xinshuanglong/PLC2STM-Project/流程图/工控机固定站调试图.png

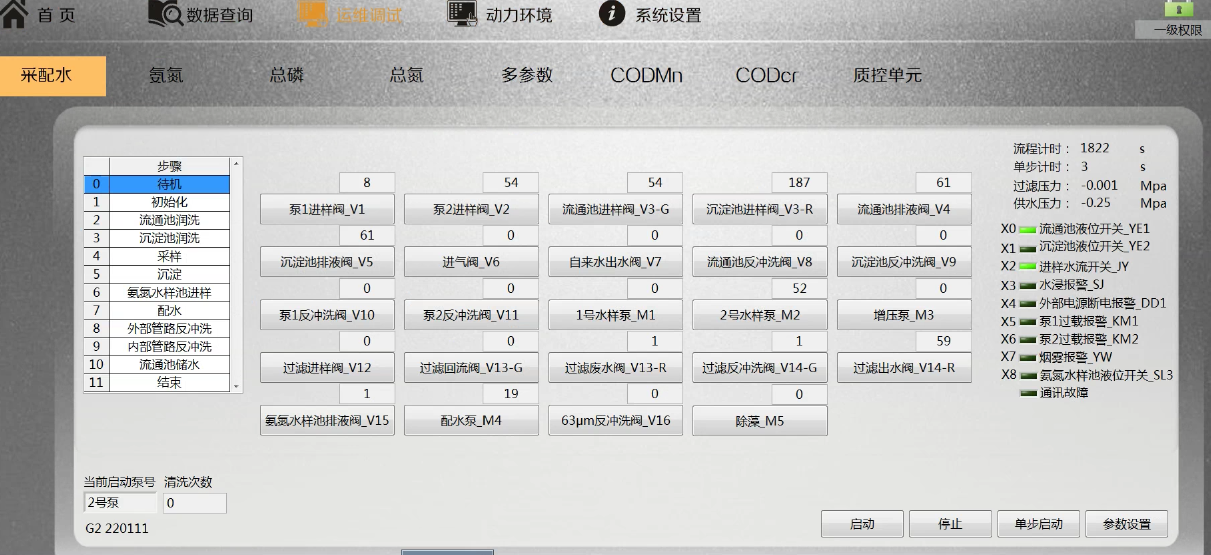
流程图/工控机固定站调试图.png
