xinshuanglong/PLC2STM-Project/流程图/一体站采配水运行逻辑图.pdf

待机 | 程序初始化 | 水箱润洗

一级水样池进
样

二级水样池进
样

多参数测量及
水样沉淀

配水

一级水样池储
水

结束

是（多参数测量完成后直接进入反冲洗流程）

水流开关及液
位开关在设定
时间内是否有
信号输出？

是否只测
多参数？

是

水流开关及液
位开关在设定
时间内是否有
信号输出?

否（发出进样超时报警，流程进入一级水样池储水流程，储水完成后进入待机状态）

是

是否启用
氨氮过滤
装置?

否（发出进样超时报警，流程进入一级水样池储水流程，储水完成后进入待机状态）

氨氮水样过滤

是

反冲洗

1. 一级水样池润洗：开启采水泵1切换阀V1-G、一级排液阀 V5，5s后开启1号水样泵M1，进行一级水样池润洗。润洗时间 到后，关闭V5，当一级液位开关信号输出后，关闭M1和V1-G。一级水样池润洗时间默认设置30s，可设置。

2.二级水样池润洗：
开启二级排液阀V4、二级进样阀V6-R，5s后开启配水泵M3， 润洗时间到后，关闭M3、二级进样阀V6-R，同时开启V5，默 认排液时间到后，关闭V4、V5。在二级水样池润洗期间，当一 级液位开关不输出信号时，一级水样池进行补水。补水流程：开 启V1-G、5s后开启M1，当一级液位开关信号输出后，关闭 M1、V1-G，补水完成。二级水样池池润洗时间默认设置30s， 可设置。

开启一级排液阀V5、二
级排液阀V4，排液时间
默认设置30s，可设置

开启采水泵1切换阀V1-G、
5s后开启1号水样泵M1，
当一级液位开关信号输出
后，关闭M1和V1-G。

开启二级进样阀V6-R，5s后开启配
水泵M3，当二级液位开关信号输出
后，关闭M3、V6-R。在二级水样池
进样期间，当一级液位开关不输出信
号时，一级水样池进行补水。补水流
程：开启V1-G、5s后开启1号水样泵
M1，当一级液位开关信号输出后，
关闭M1、V1-G，补水完成。

沉淀时间默认1800s, 可设置。

否

1.常规配水时间默认1800s，加标回收配
水时间默认5400s，可设置。
2.配水期间，若氨氮水样池液位低于液位
开关，自动启动过滤补水。补水流程为：
开启过滤装置进样阀V6-G、过滤装置回流
阀V11-G、过滤出水阀V12-R，5s后开启
配水泵M3，氨氮水样池液位开关输出信号
后，关闭M3、V6-G、V11-G、V12-R，
完成氨氮水样池补水。

1.过滤装置润洗：
启动过滤水样池排液阀V13，排液时间到后，开启过
滤装置进样阀V6-G，过滤装置废水阀V11-R，过滤出 水阀V12-R,5s后启动配水泵M3，进行过滤装置润 洗，润洗时间默认设置10s,时间可设置。
2.氨氮水样池润洗：
过滤装置润洗时间到后，关闭M3,V11-R,开启过滤装 置回流阀V11-G,5s后启动配水泵M3,进行氨氮水样池 润洗。润洗时间默认10s，时间可设置。
3.过滤进样：
氨氮水样池润洗时间到后，关闭过滤水样池排液阀
V13,进行过滤进样，氨氮水样池液位开关输出信号
后，关闭M3、过滤装置进样阀V6-G、过滤装置回流
阀V11-G，完成过滤进样流程。
4.异常报警：
若过滤进样时间超过设定值，直接进入配水流程，同
时输出报警过滤装置异常，氨氮模块停止测量。
5.保护程序：
在过滤装置和氨氮水样池润洗时，若氨氮水样池液位
开关输出信号，则关闭除了过滤水样池排液阀V13的
所有阀和泵，默认排液时间到后，关闭V13，进入待
机状态

1.若选择水样储水：
开启采水泵1切换阀V1-G,5s后开启1号水样泵M1，到 达设定的储水时间或者一级液位开关输出信号后，关
闭M1和V1-G,完成储水。储水时间可设置。
2.若选择进自来水储水：
开启过滤装置出水阀V12-R，一级反冲洗阀V2、自来 水出水阀V8,5s后开启增压泵M4,到达设定的储水时间 或者一级水样池液位开关输出信号后，关闭M4、
V8、V12-R和V2，完成储水。储水时间可设置。

1.水箱排液：
开启一级排液阀V5，二级排液阀V4，排液时间到后，开启过滤水样池排液阀 V13。排液时间到后，关闭V4、V5和V13。排液时间默认30s,可设置。 2.外部管路反冲洗: 开启采水泵1切换阀V1-G、采水泵1反冲洗阀V9、过滤出水阀V12-R、自来水出水

阀V8,5s后开启增压泵M4，进行外部管路反冲洗，反冲洗时间到后，关闭M4、 V1-G、V8、V9和V12-R。外部管路反冲洗时间默认120s，可设置。 3.内部管路反冲洗：
3.1 开启63um滤芯反冲洗阀V14、二级进样阀V6-R、过滤装置进样阀V6-G、 过滤装置废水阀V11-R、自来水出水阀V8，5s后开启增压泵M4，进行63um滤芯 反冲洗，反冲洗时间到后，关闭M4、V8，开启空压机出气阀V7，进气时间到后， 关闭V7、V6-R、V6-G、V11-R、V14,完成63um滤芯反冲洗。进气时间默认 30s，可设置。
3.2 开启二级进样阀V6-R、过滤装置废水阀V11-R、过滤反冲洗阀V12-G、自 来水出水阀V8,5s后开启增压泵M4，过滤清洗时间到后，关闭M4、V8，开启空压 机出气阀V7,进气时间到后，关闭V7、V6-R、V11-R、V12-G,开启过滤出水阀 V12-R，完成过滤装置反冲洗。过滤装置反冲洗时间默认180s，可设置。 3.3开启一级排液阀V5，一级反冲洗阀V2，自来水出阀V8，5s后开启增压泵 M4，一级反冲洗时间到后，关闭M4、V8、V5、V2、完成一级水样池反冲洗。 一 级水样池反冲洗时间60s，可设置 。
3.4开启二级排液阀V4、二级反冲洗阀V3、自来水出水阀V8，5s后开启增压泵 M4，二级水样池反冲时间到后，关闭M4，V8，V4，V3，完成二级水样池反冲 洗。 二级水样池反冲洗时间60s，可设置。
3.5开启二级进样阀V6-R、过滤反冲洗阀V12-G，过滤装置废水阀V11-R,5s后 开启空压机出气阀V7，进气时间到后，关闭V7、V6-R、V11-R、V12-G,完成过滤 装置滤芯吹气。

否

# 微站采配水运行逻辑图

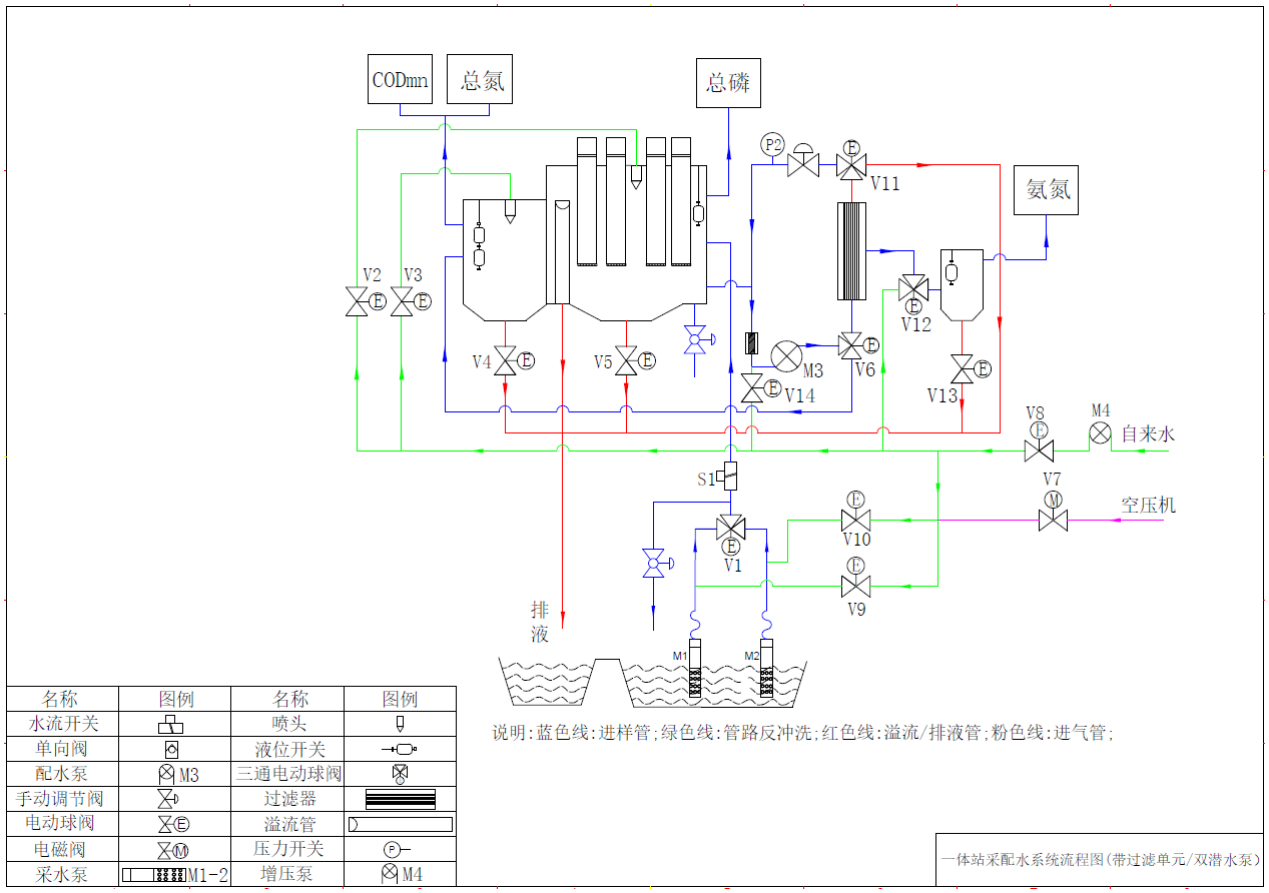
[picture p9: figure]
