xinshuanglong/PLC2STM-Project/流程图/工控机一体站配置图.png

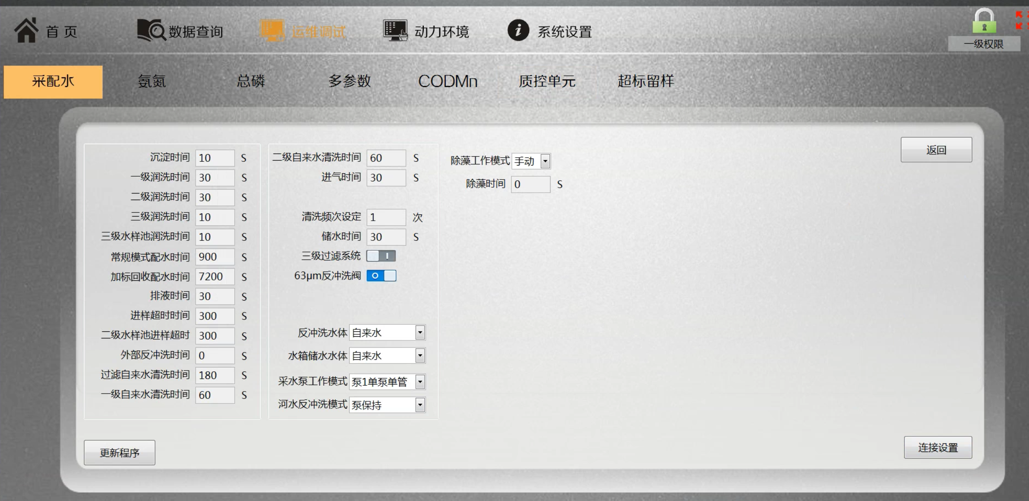
流程图/工控机一体站配置图.png
