xinshuanglong/PLC2STM-Project/Hardware/PLC转单片机主板总原理图设计-22.7.16.pdf

# JTAG TF卡

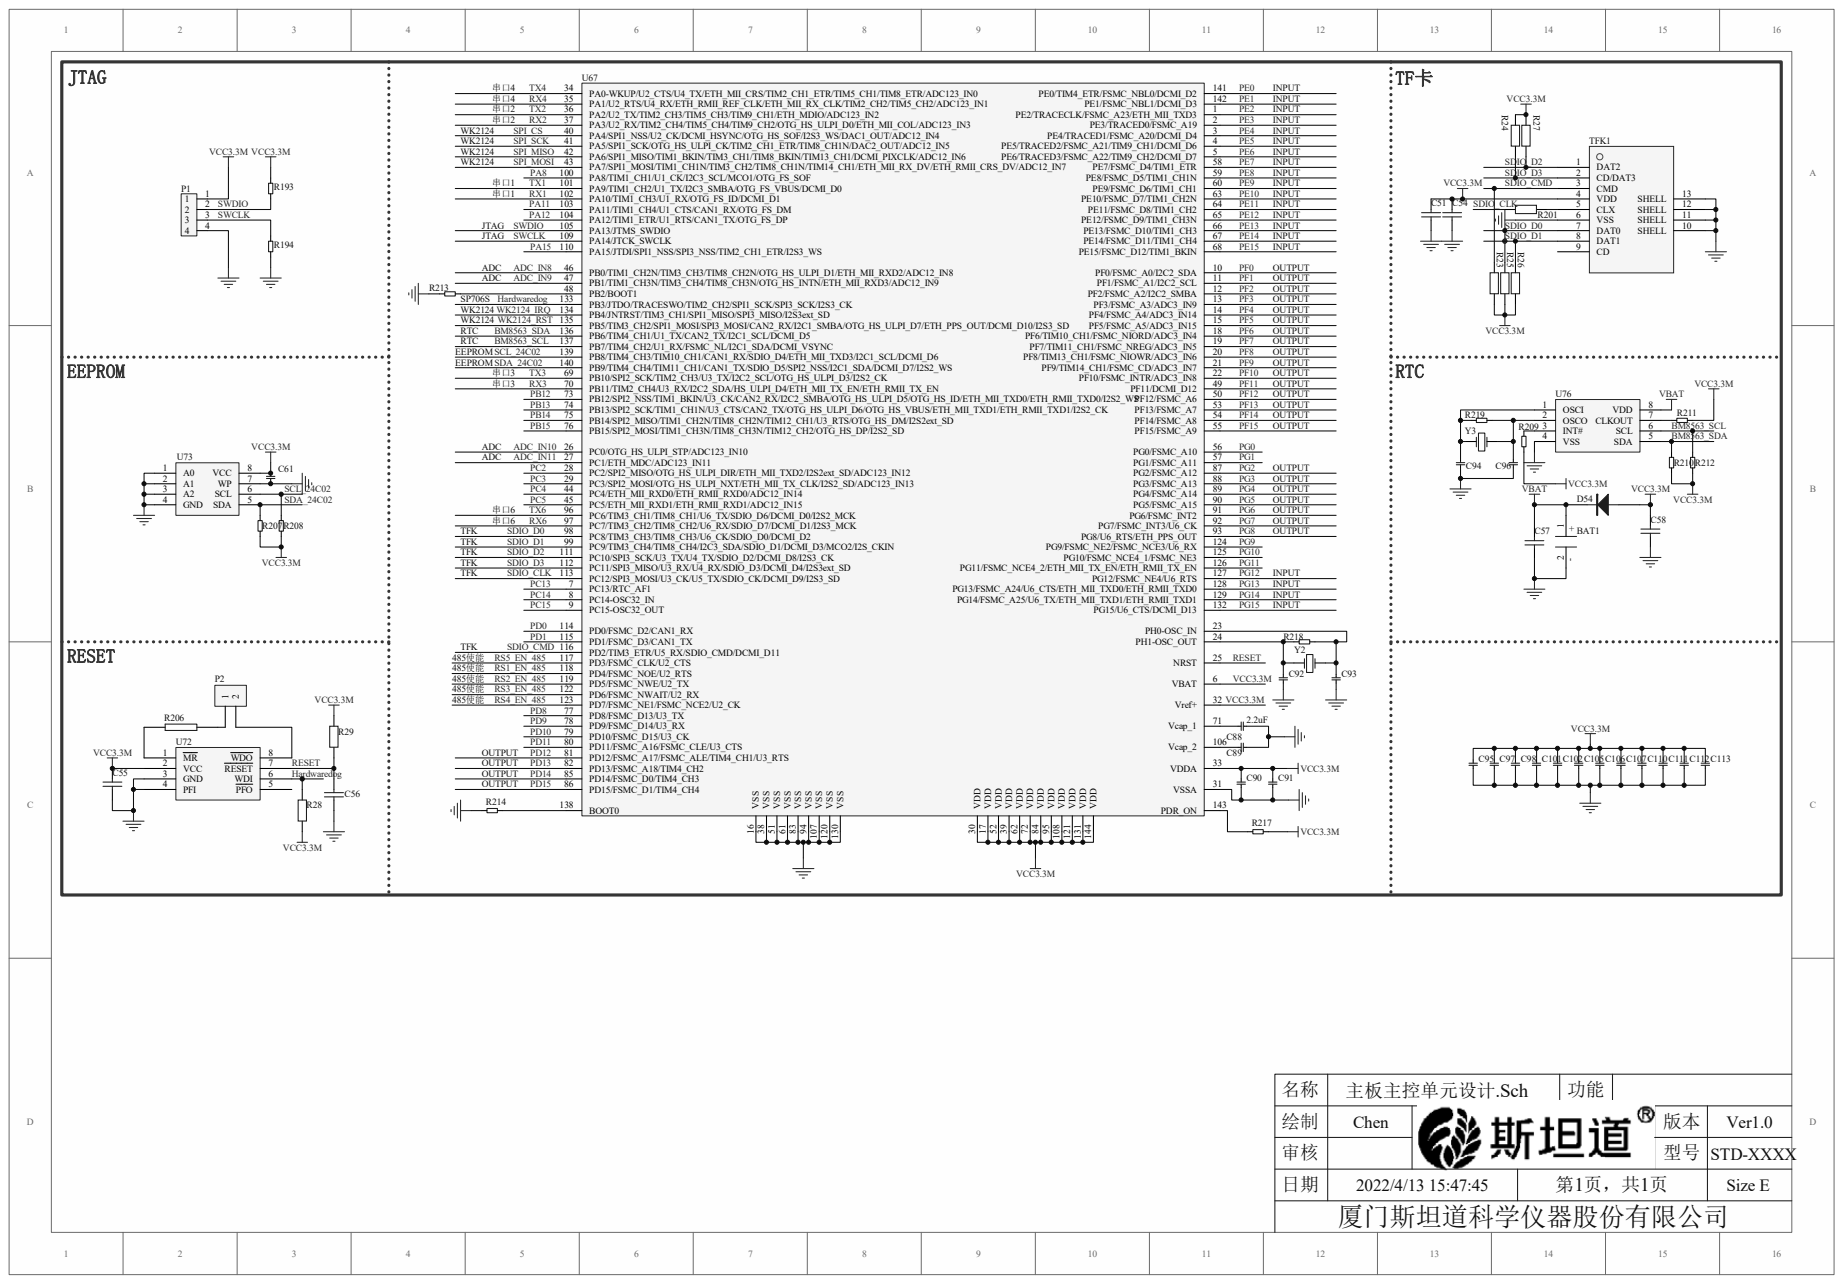
[picture p12: page 1]

# POWER INPUT Relay POWER SUPPLY

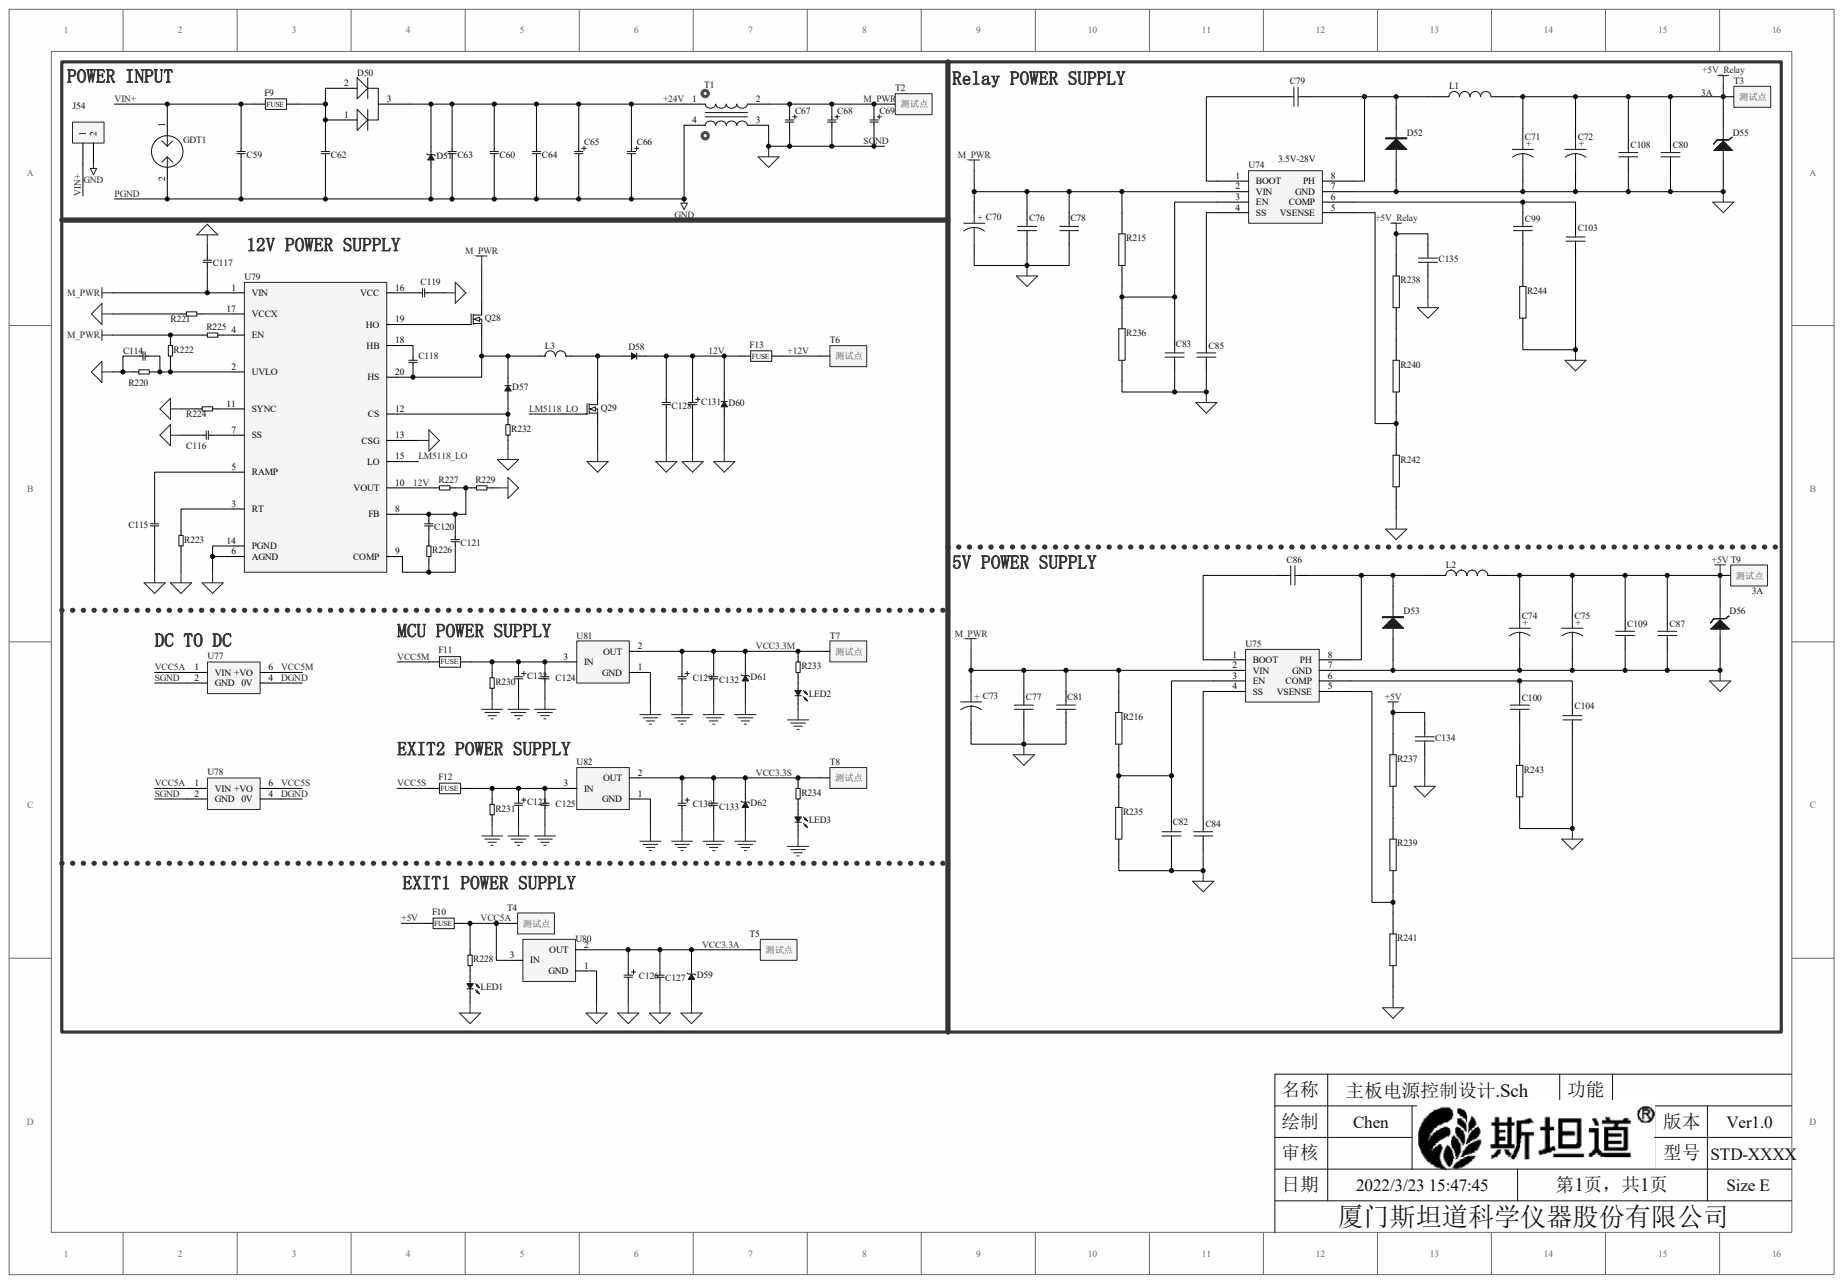
[picture p13: page 2]

MCU POWER SUPPLY DC TO DC

## RS232供电选择，两个电阻只能焊一个

232通讯

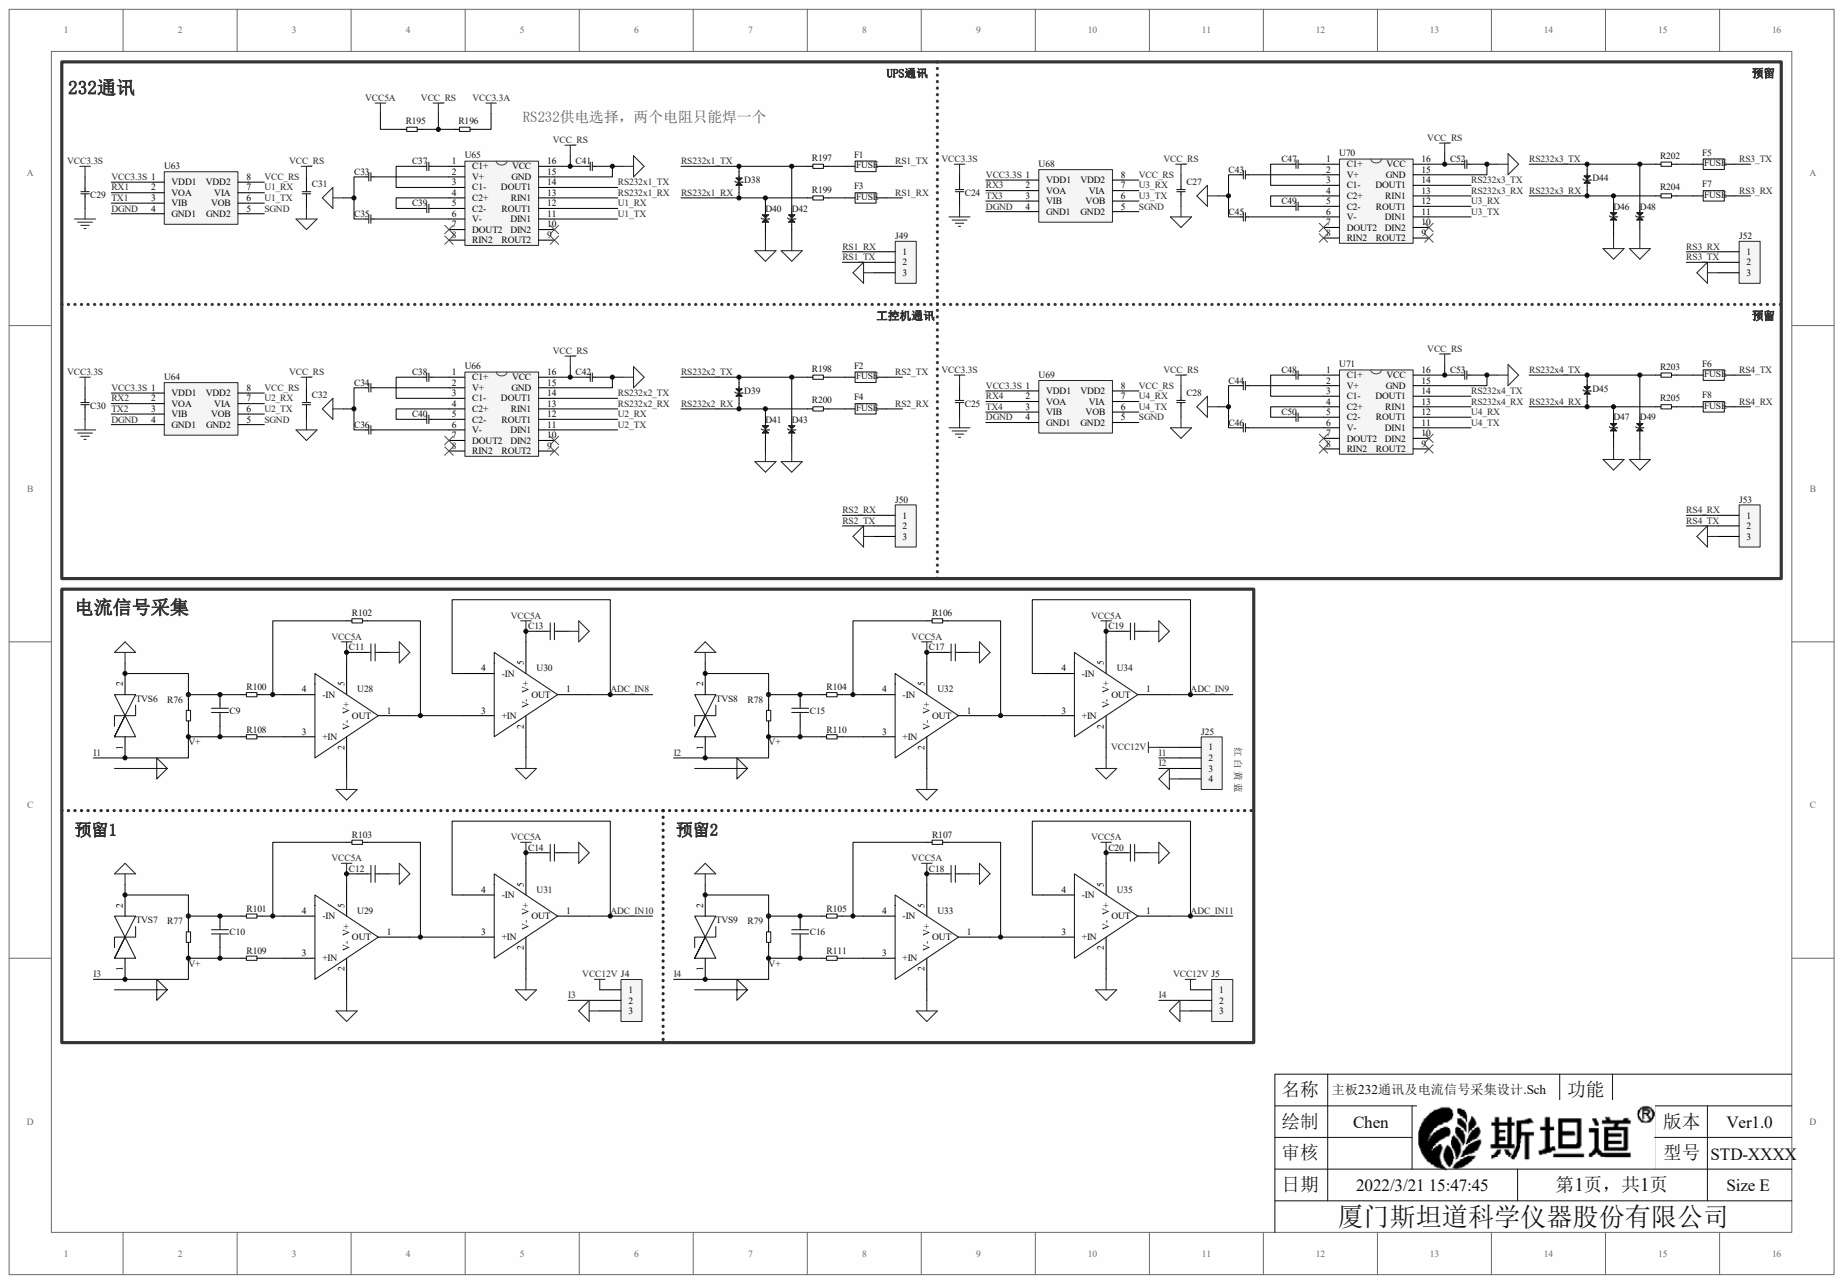
[picture p14: page 3]

485通讯

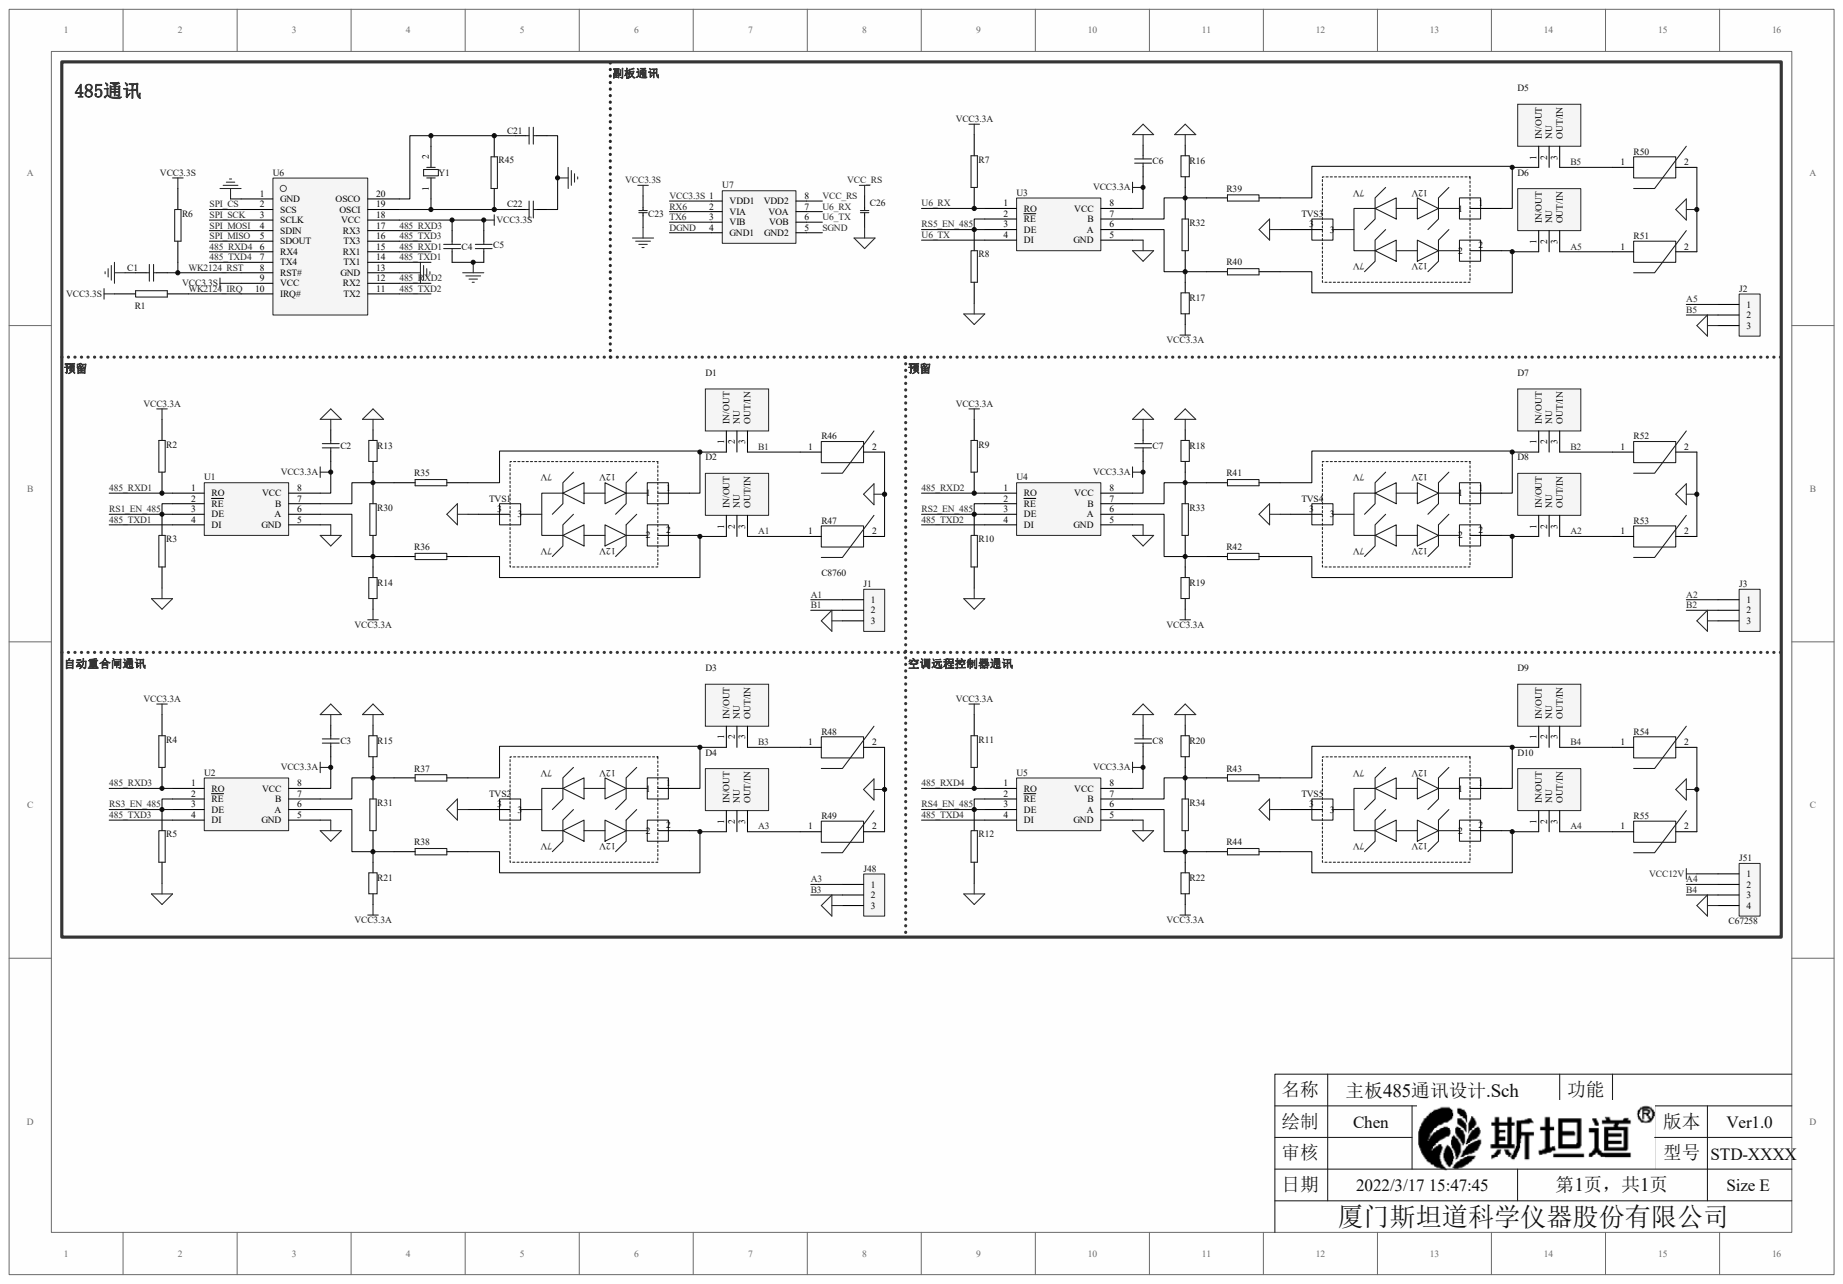
[picture p15: page 4]

## 12V Relay Control

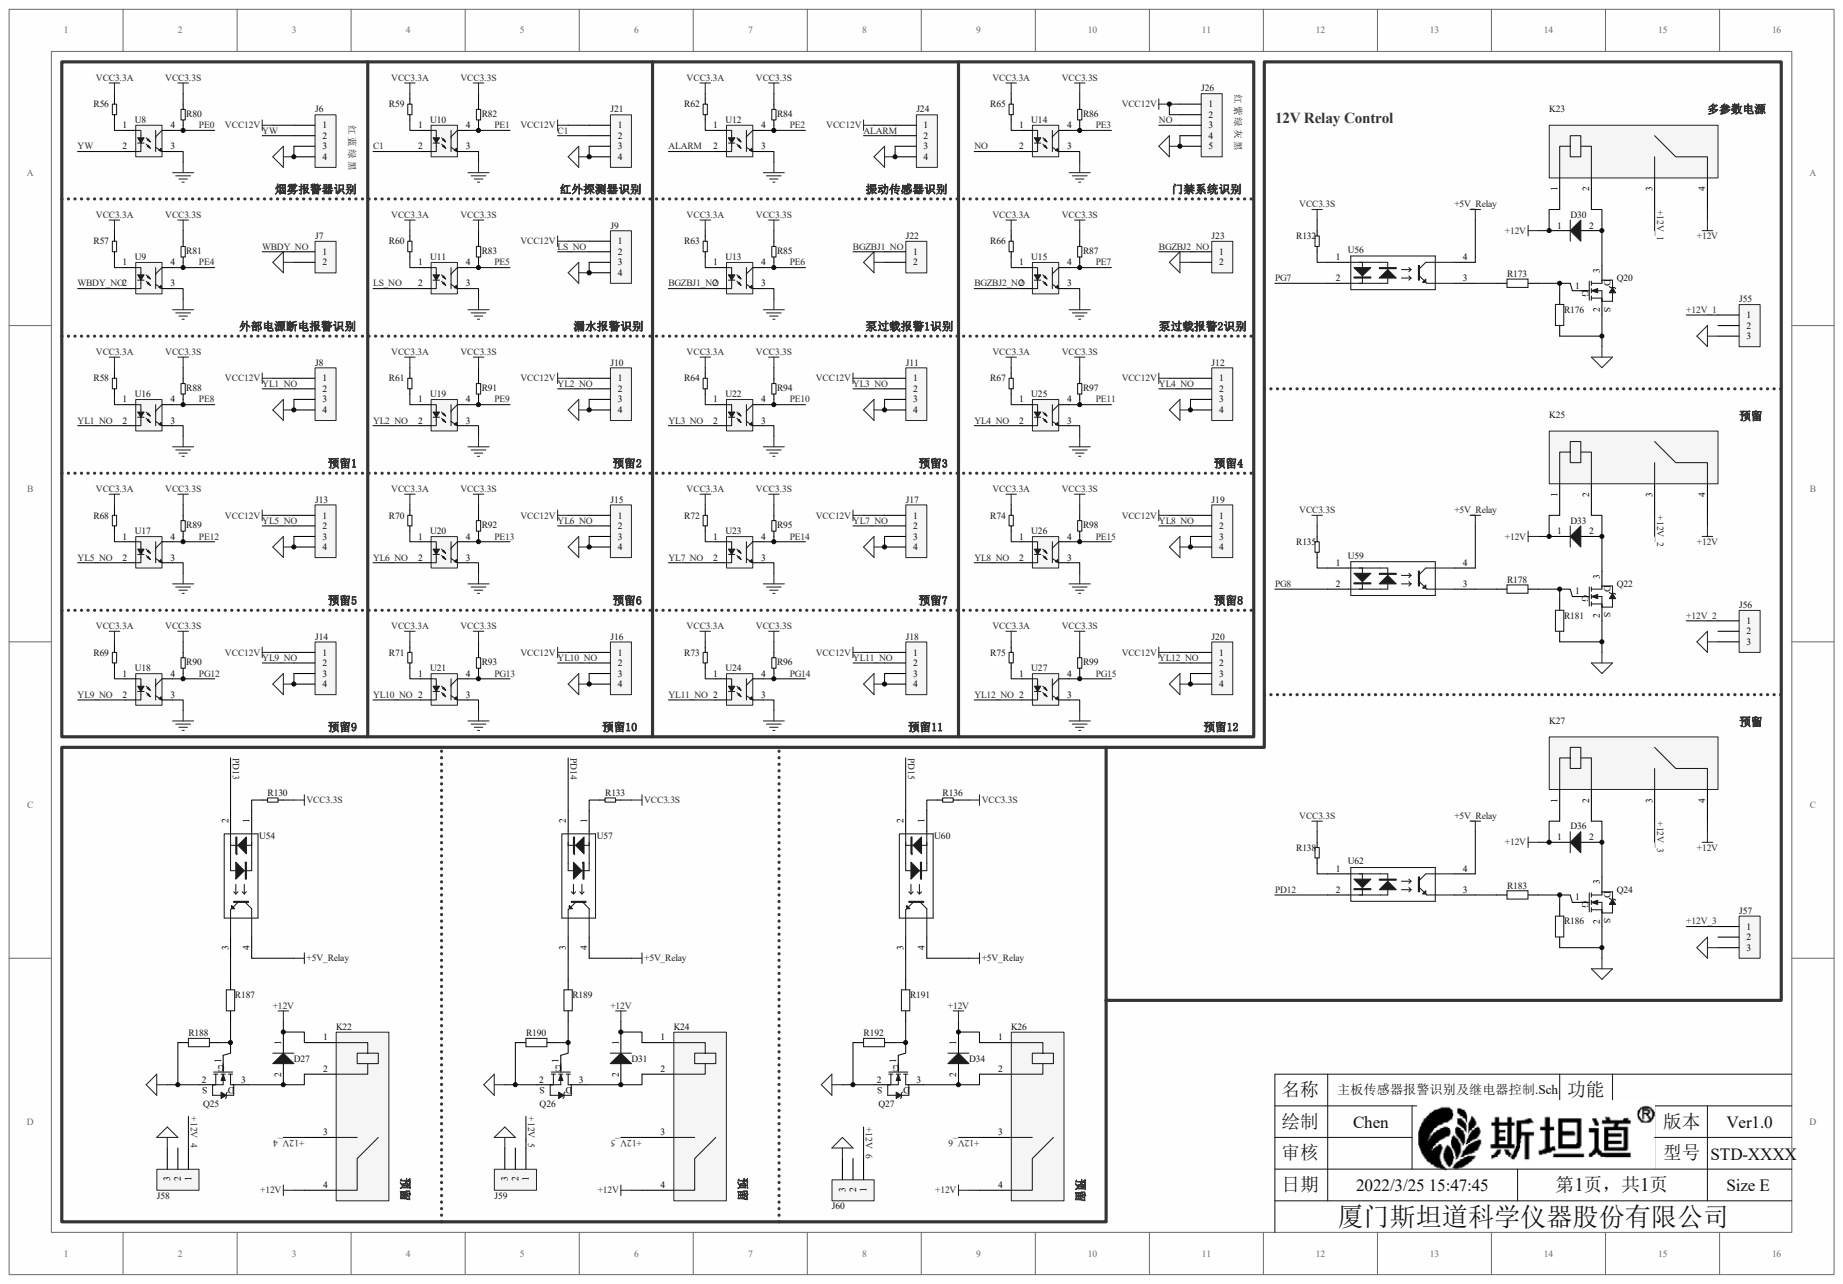
[picture p16: page 5]

## 24V Relay Control

## 24V Relay Control

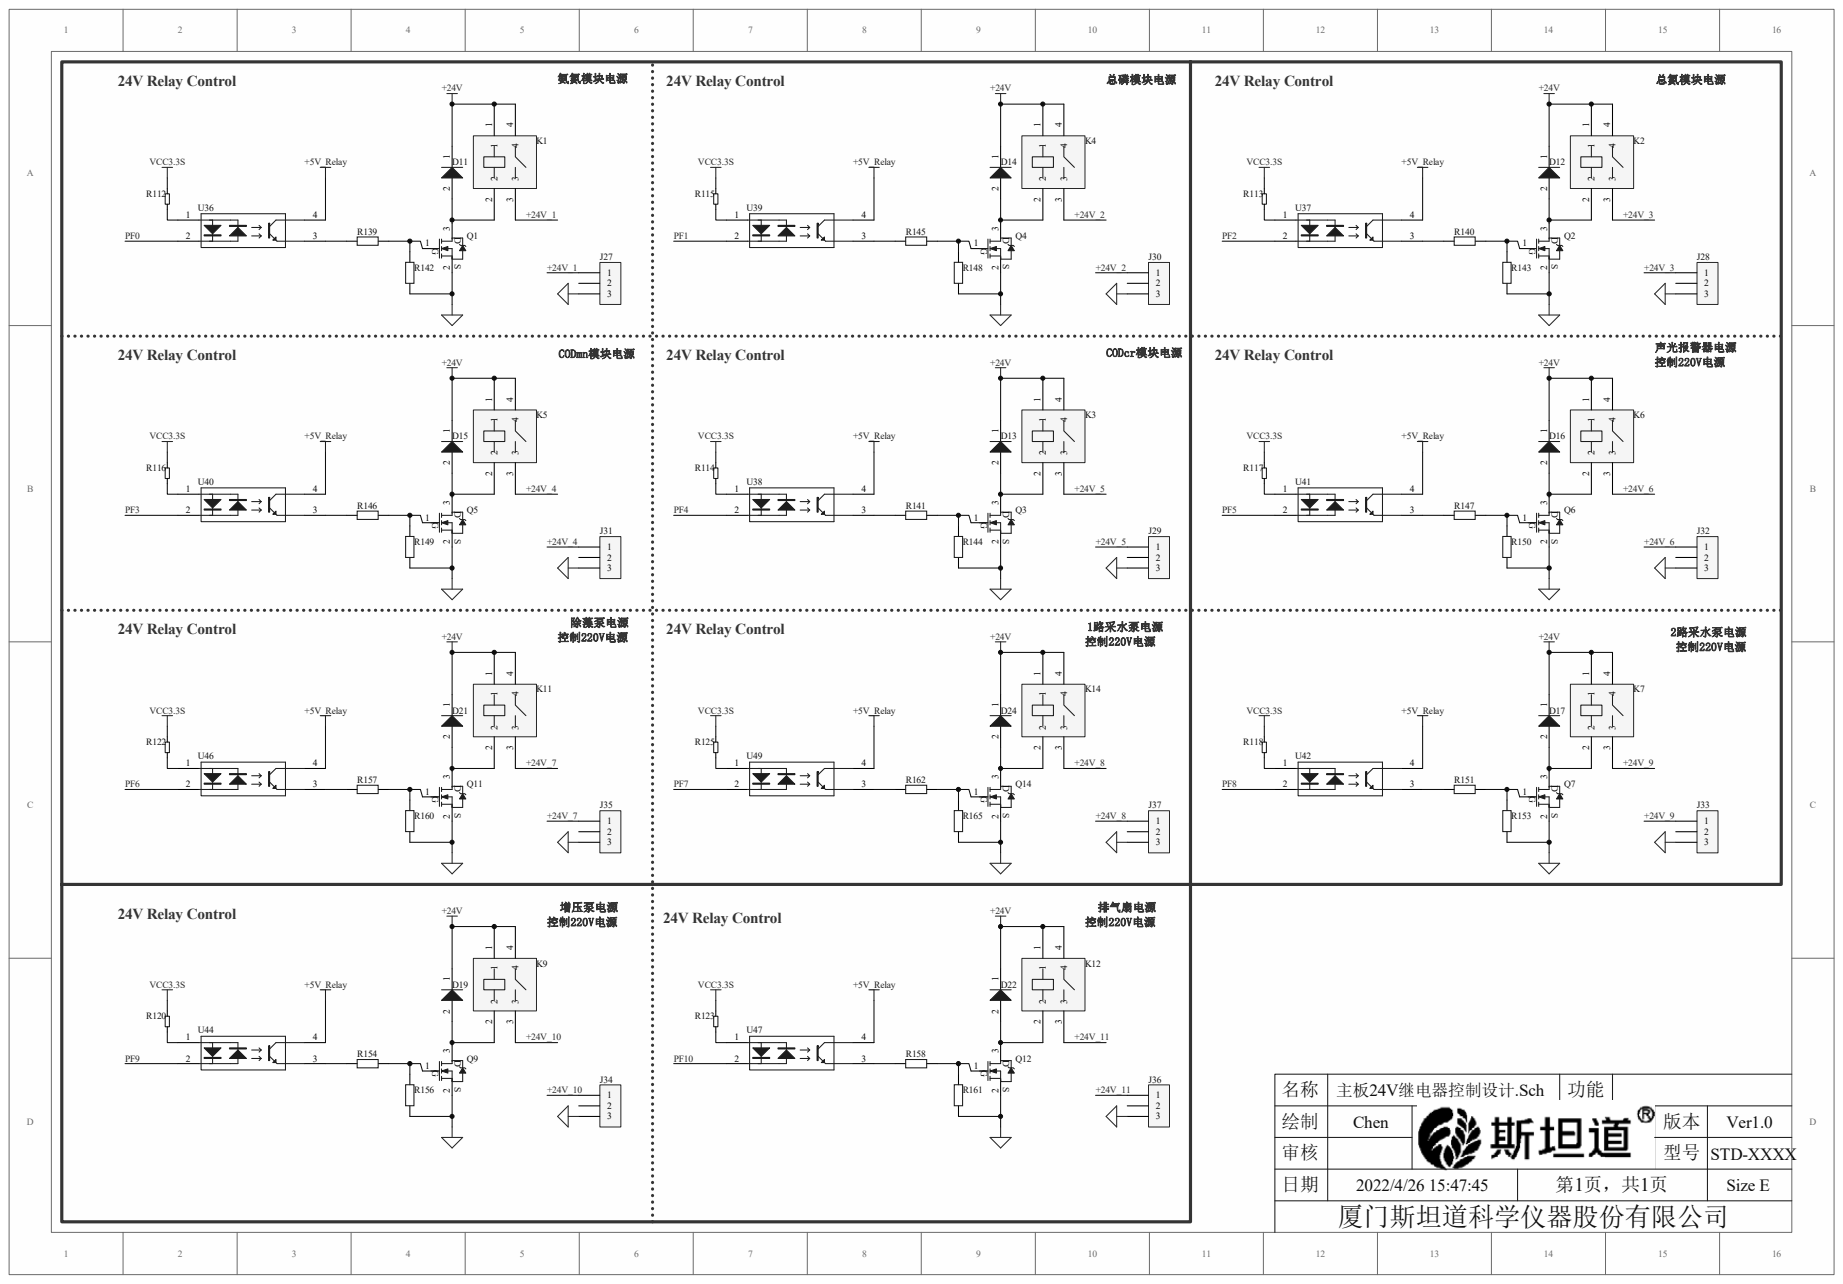
[picture p17: page 6]

## 24V Relay Control

## 24V Relay Control

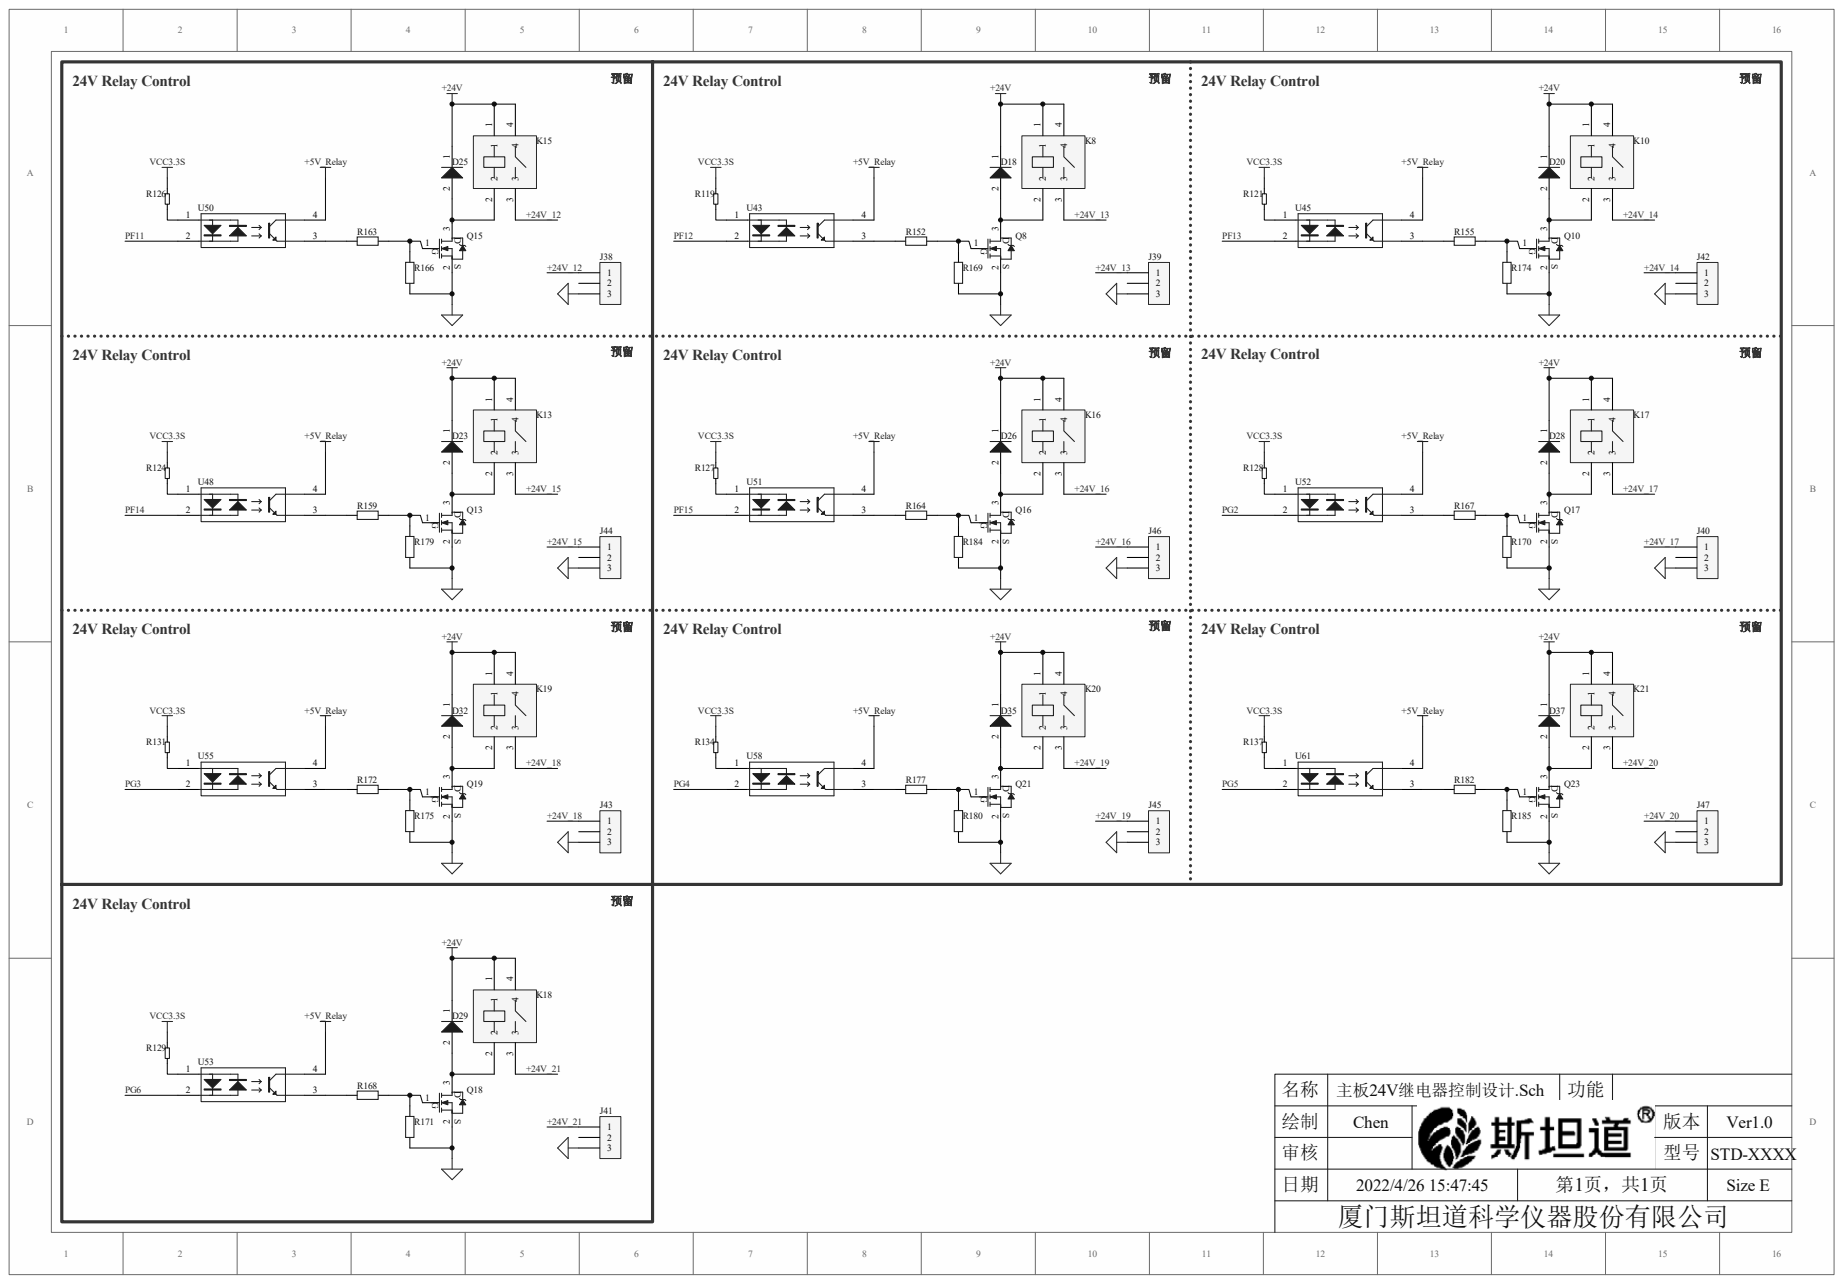
[picture p18: page 7]
