xinshuanglong/PLC2STM-Project/Hardware/PLC转单片机副板总原理图设计-22.7.14.pdf

JTAG | EEPROM

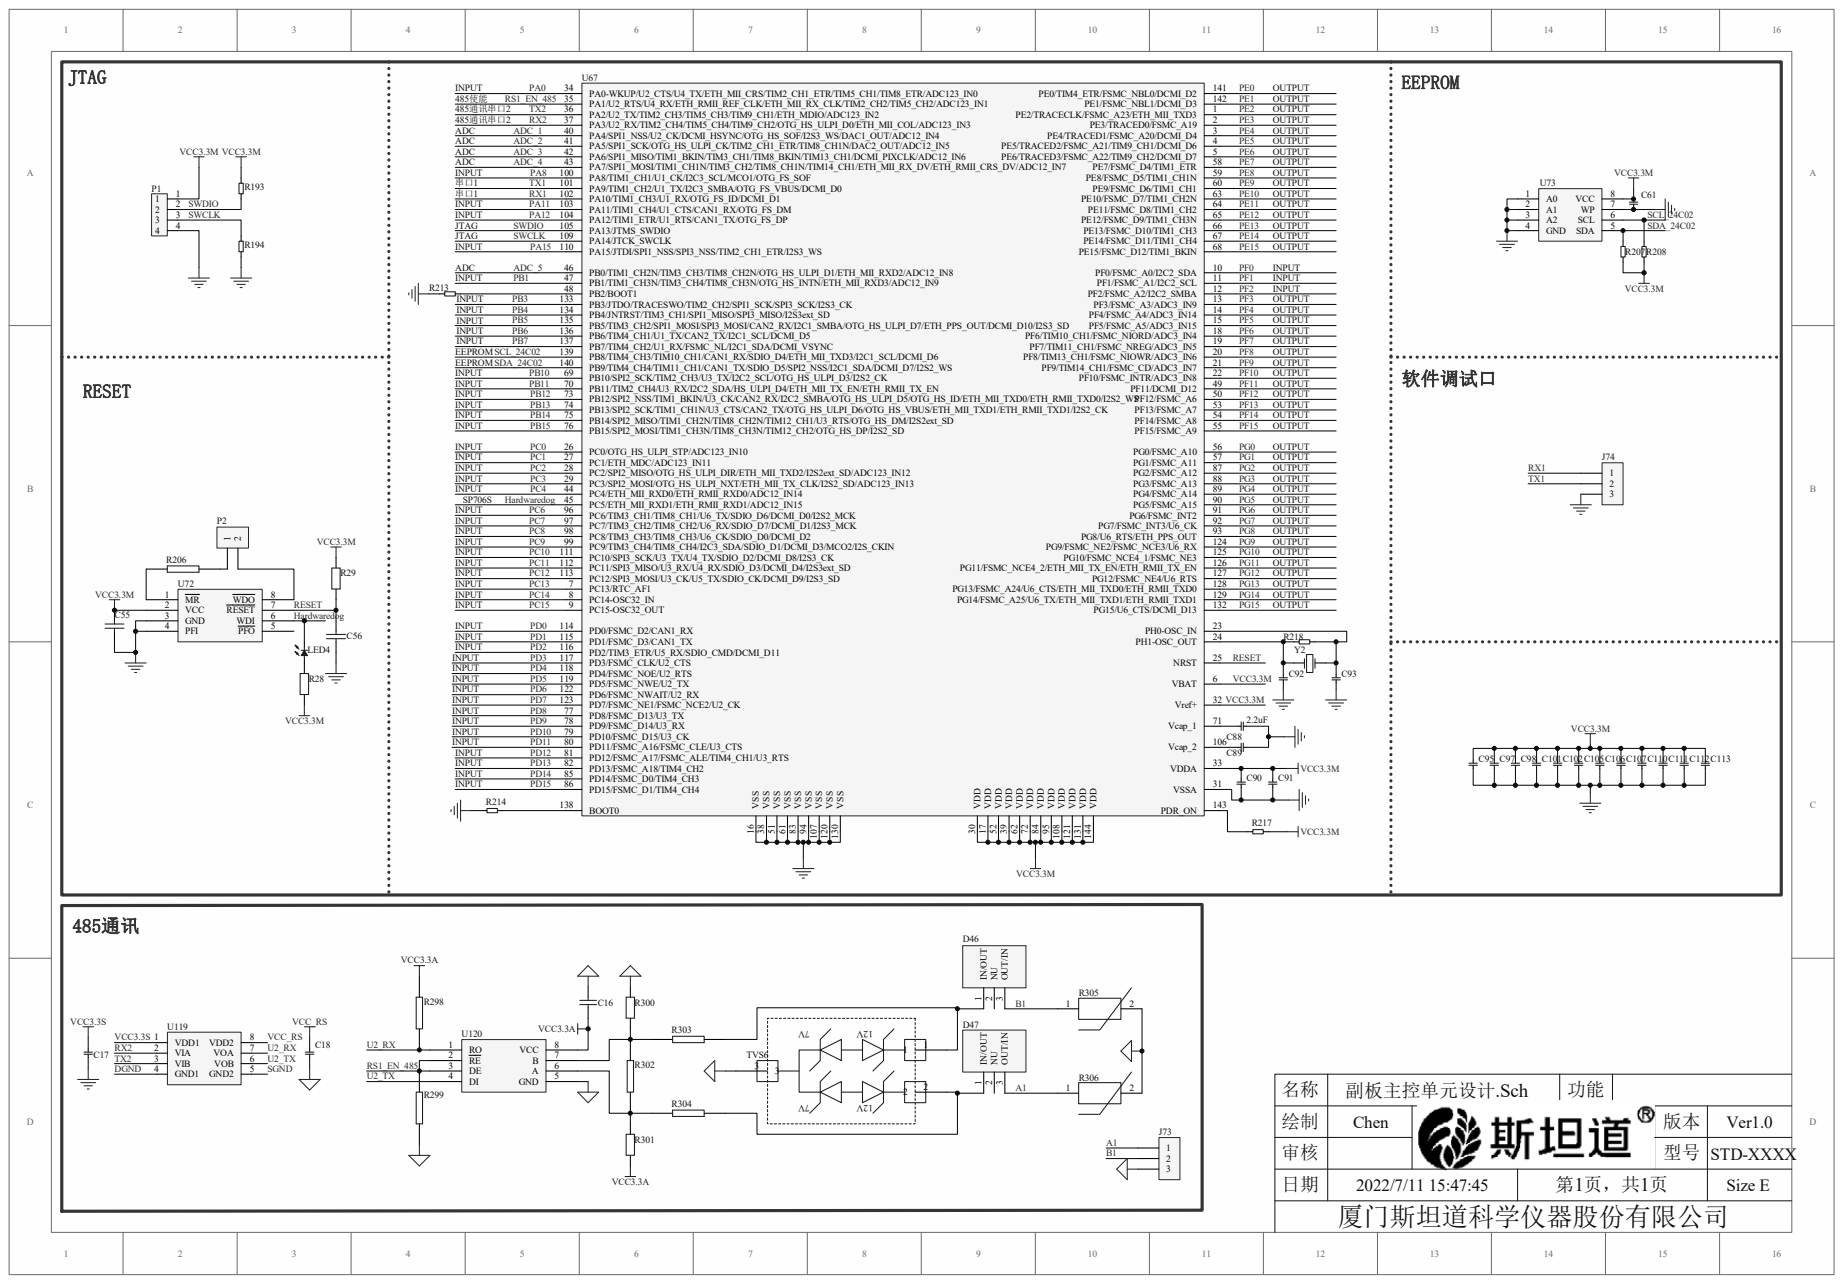
[picture p19: page 1]

# POWER INPUT Relay POWER SUPPLY

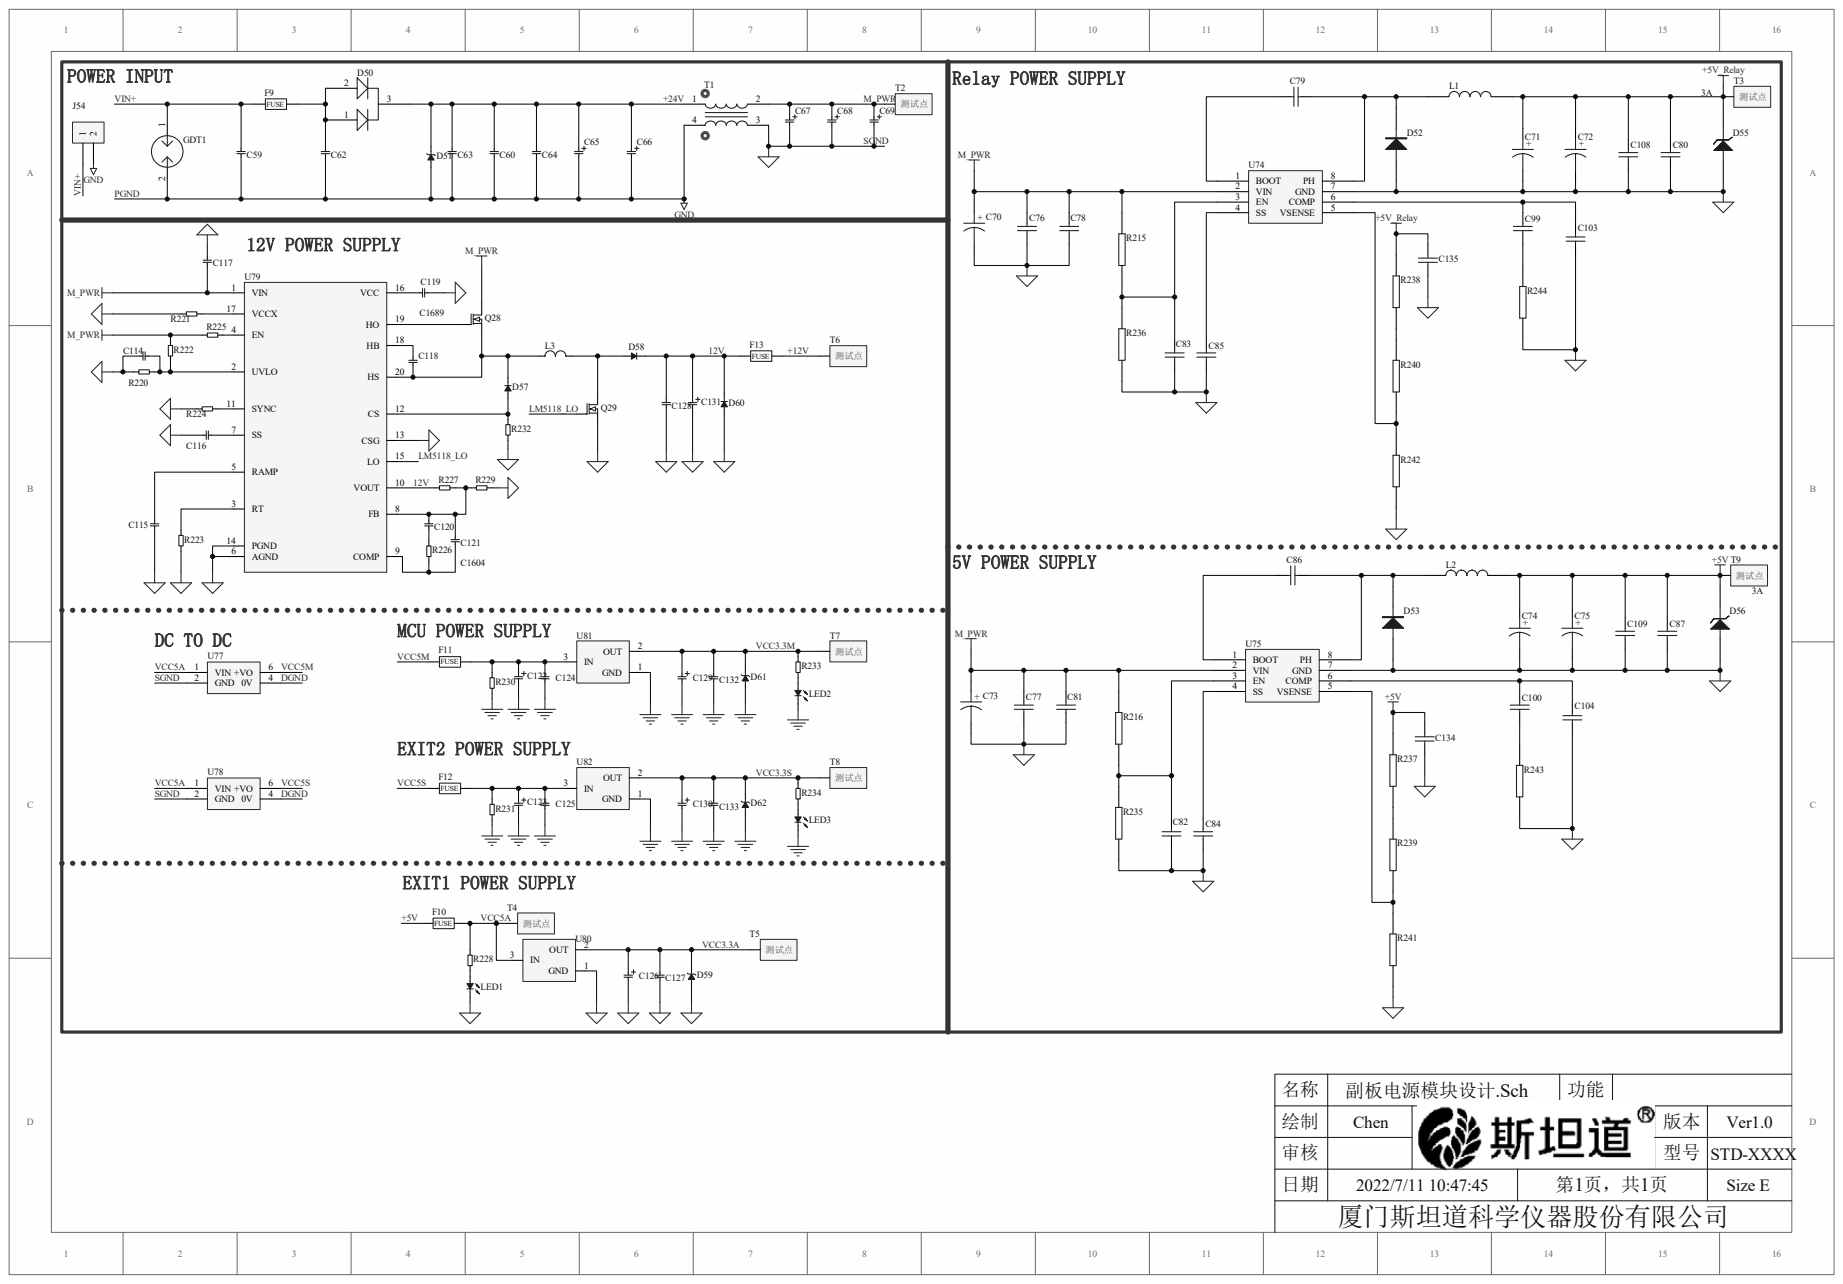
[picture p20: page 2]

MCU POWER SUPPLY DC TO DC

# 压力传感器电流信号采集

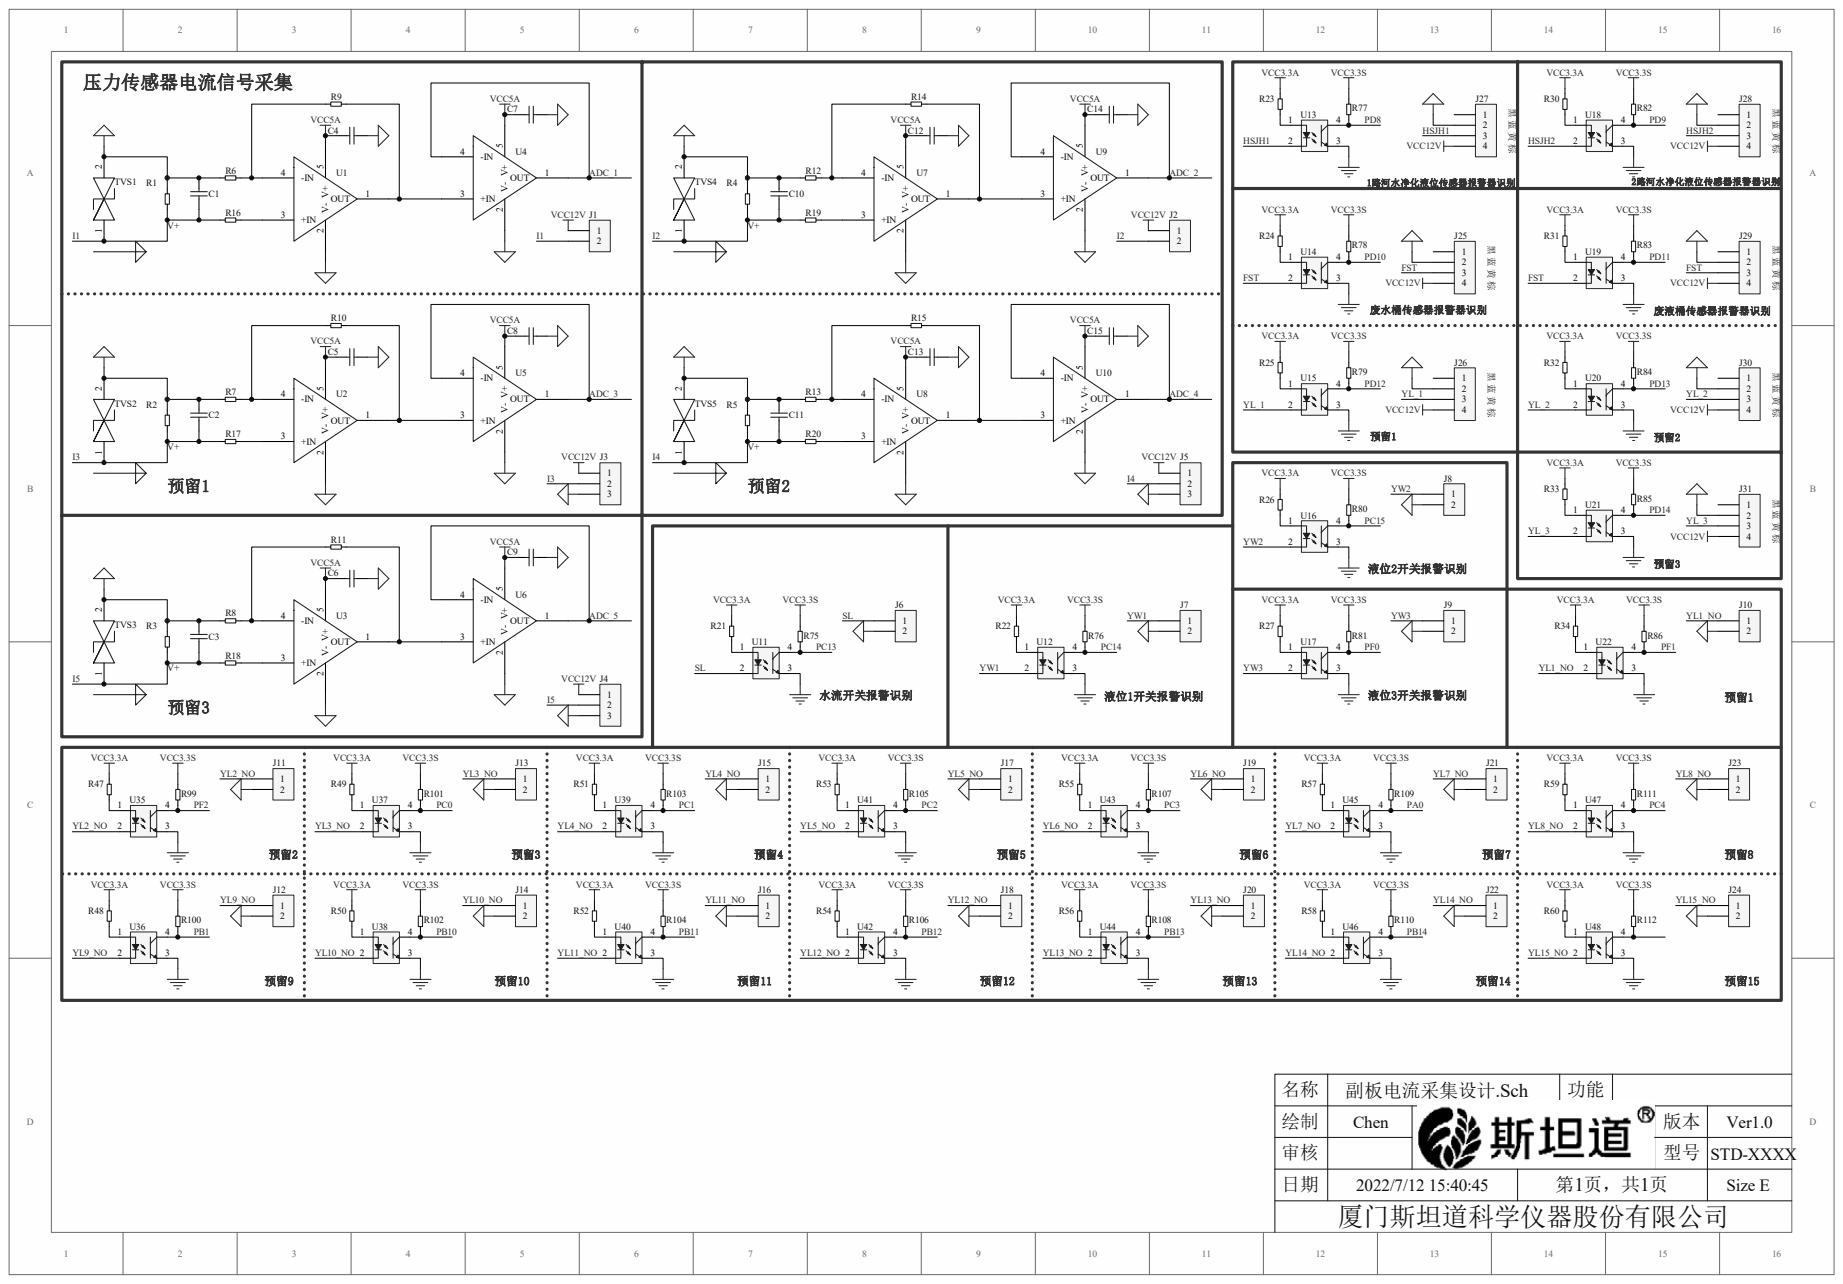
[picture p21: page 3]

Chen | | 版本 | Ver1.0

型号 | STD-XXXX

2022/7/12 15:40:45 | 第1页，共1页 | Size E

# 2通电动球阀开关报警识别

1

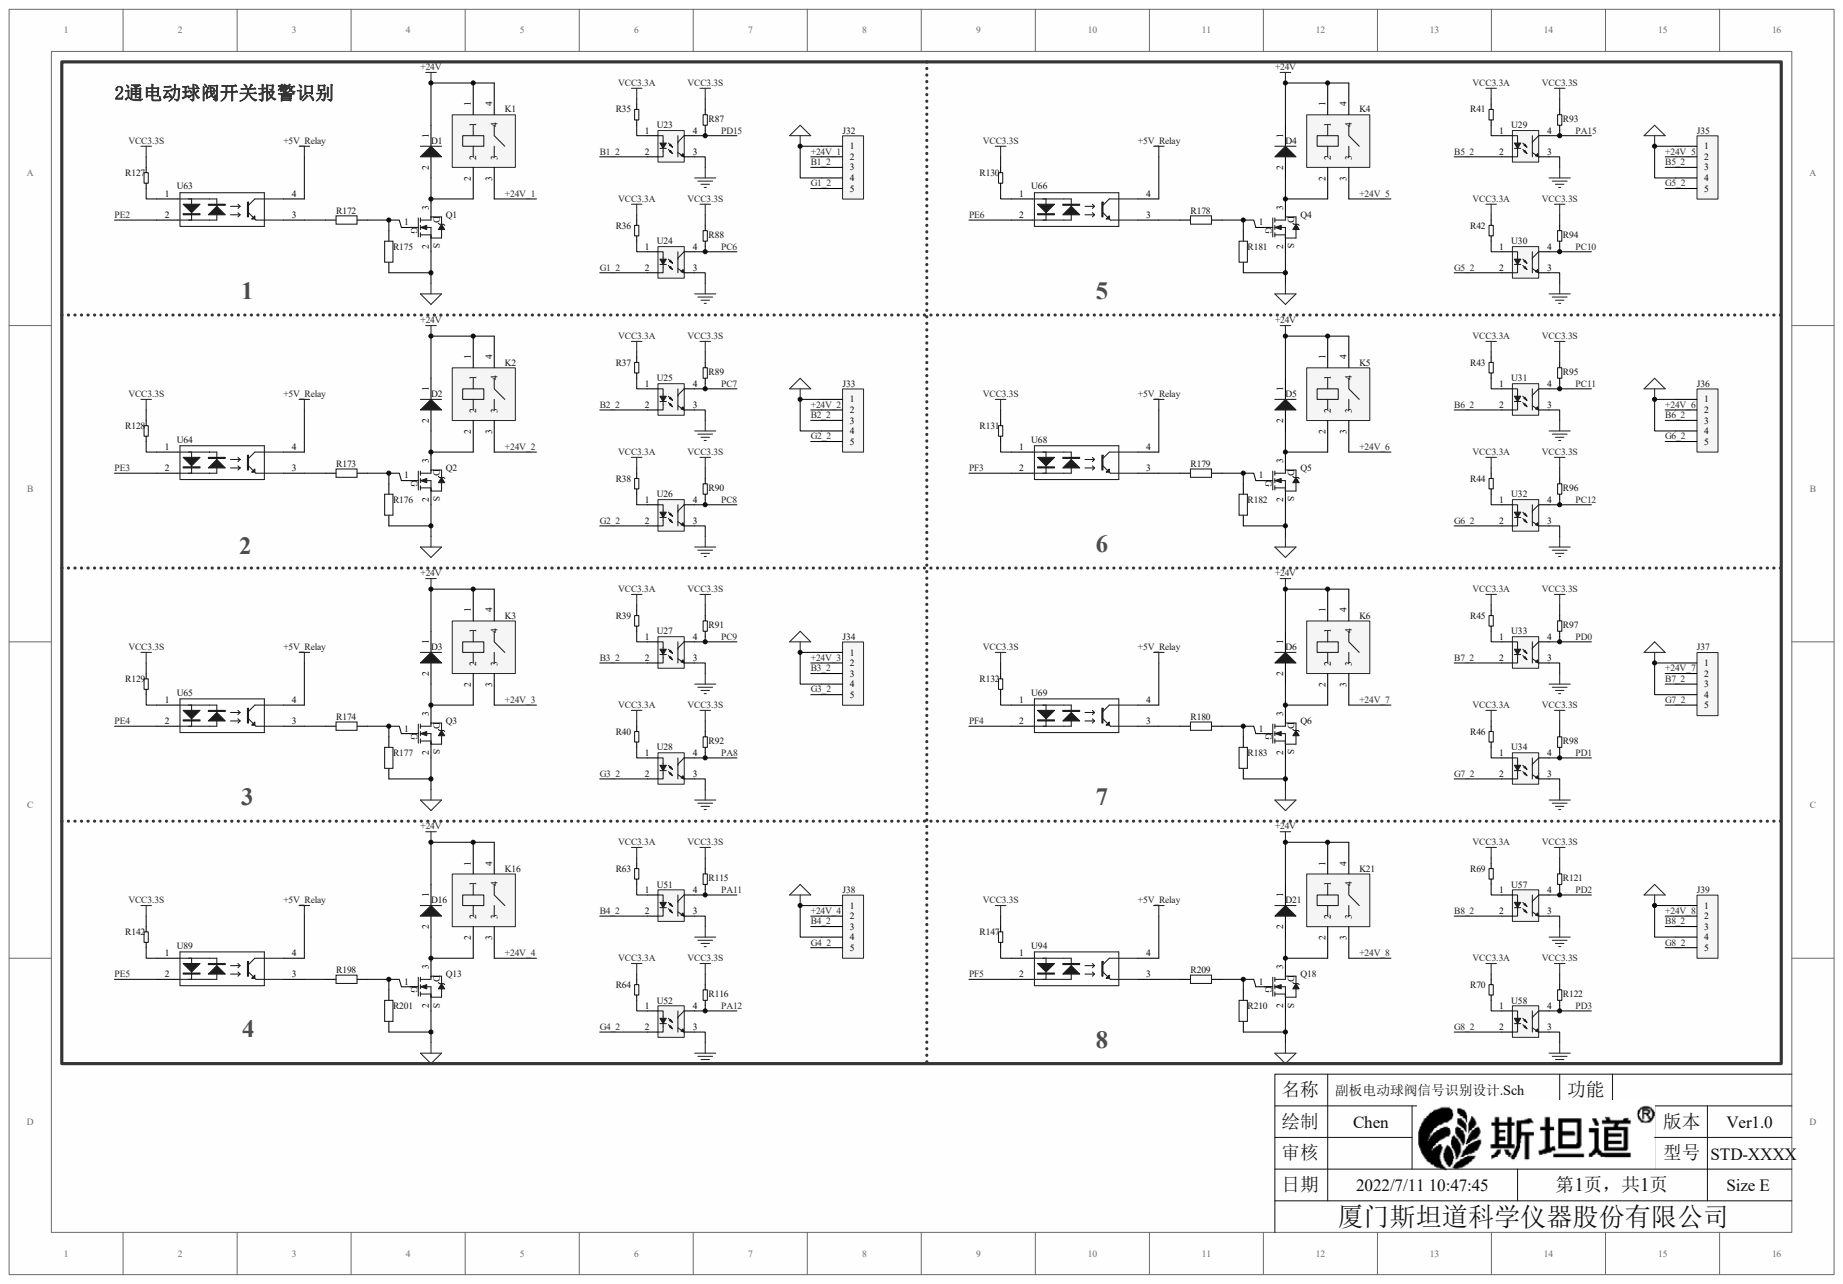
[picture p22: page 4]

# 3通电动球阀开关报警识别

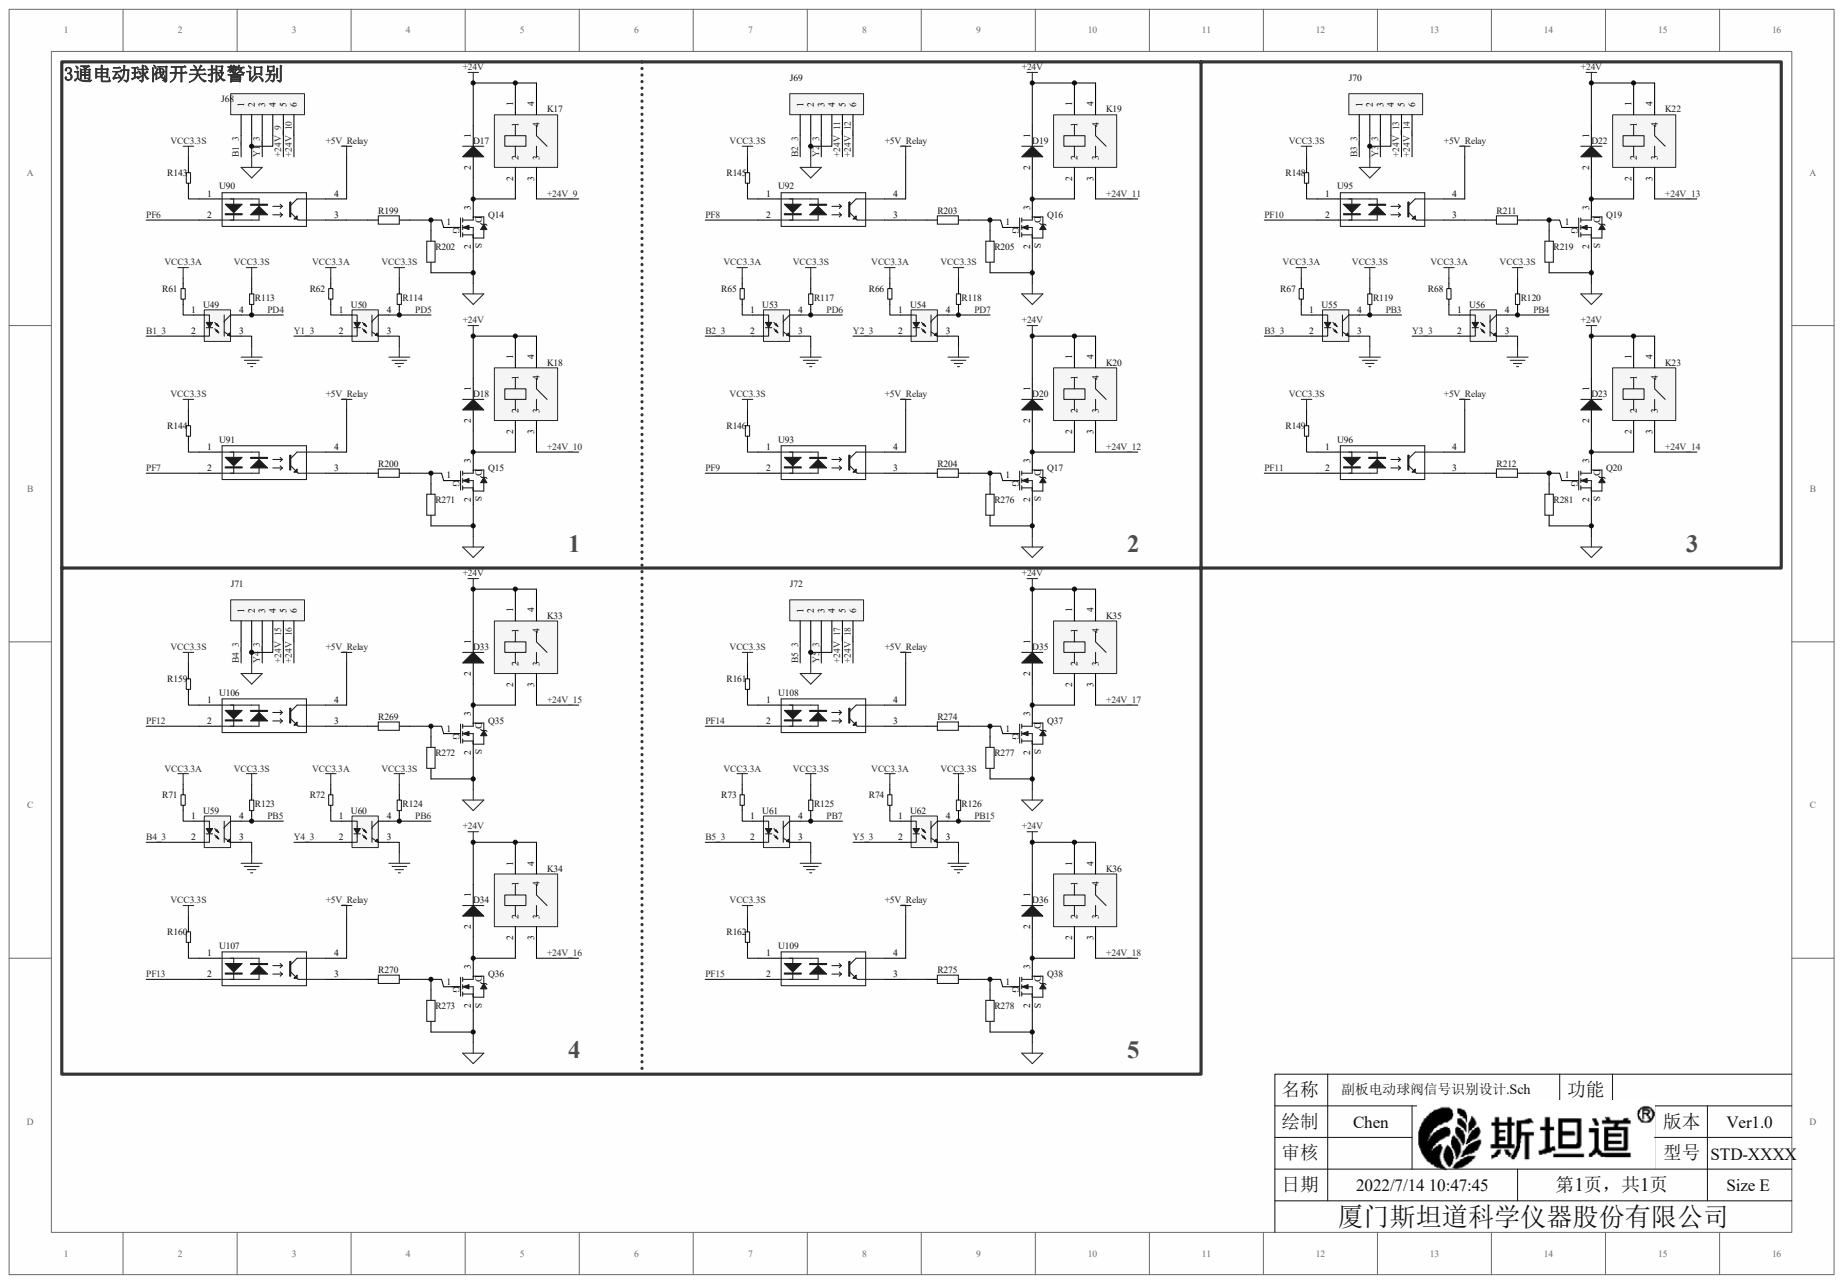
[picture p23: page 5]

# 24V Relay Control

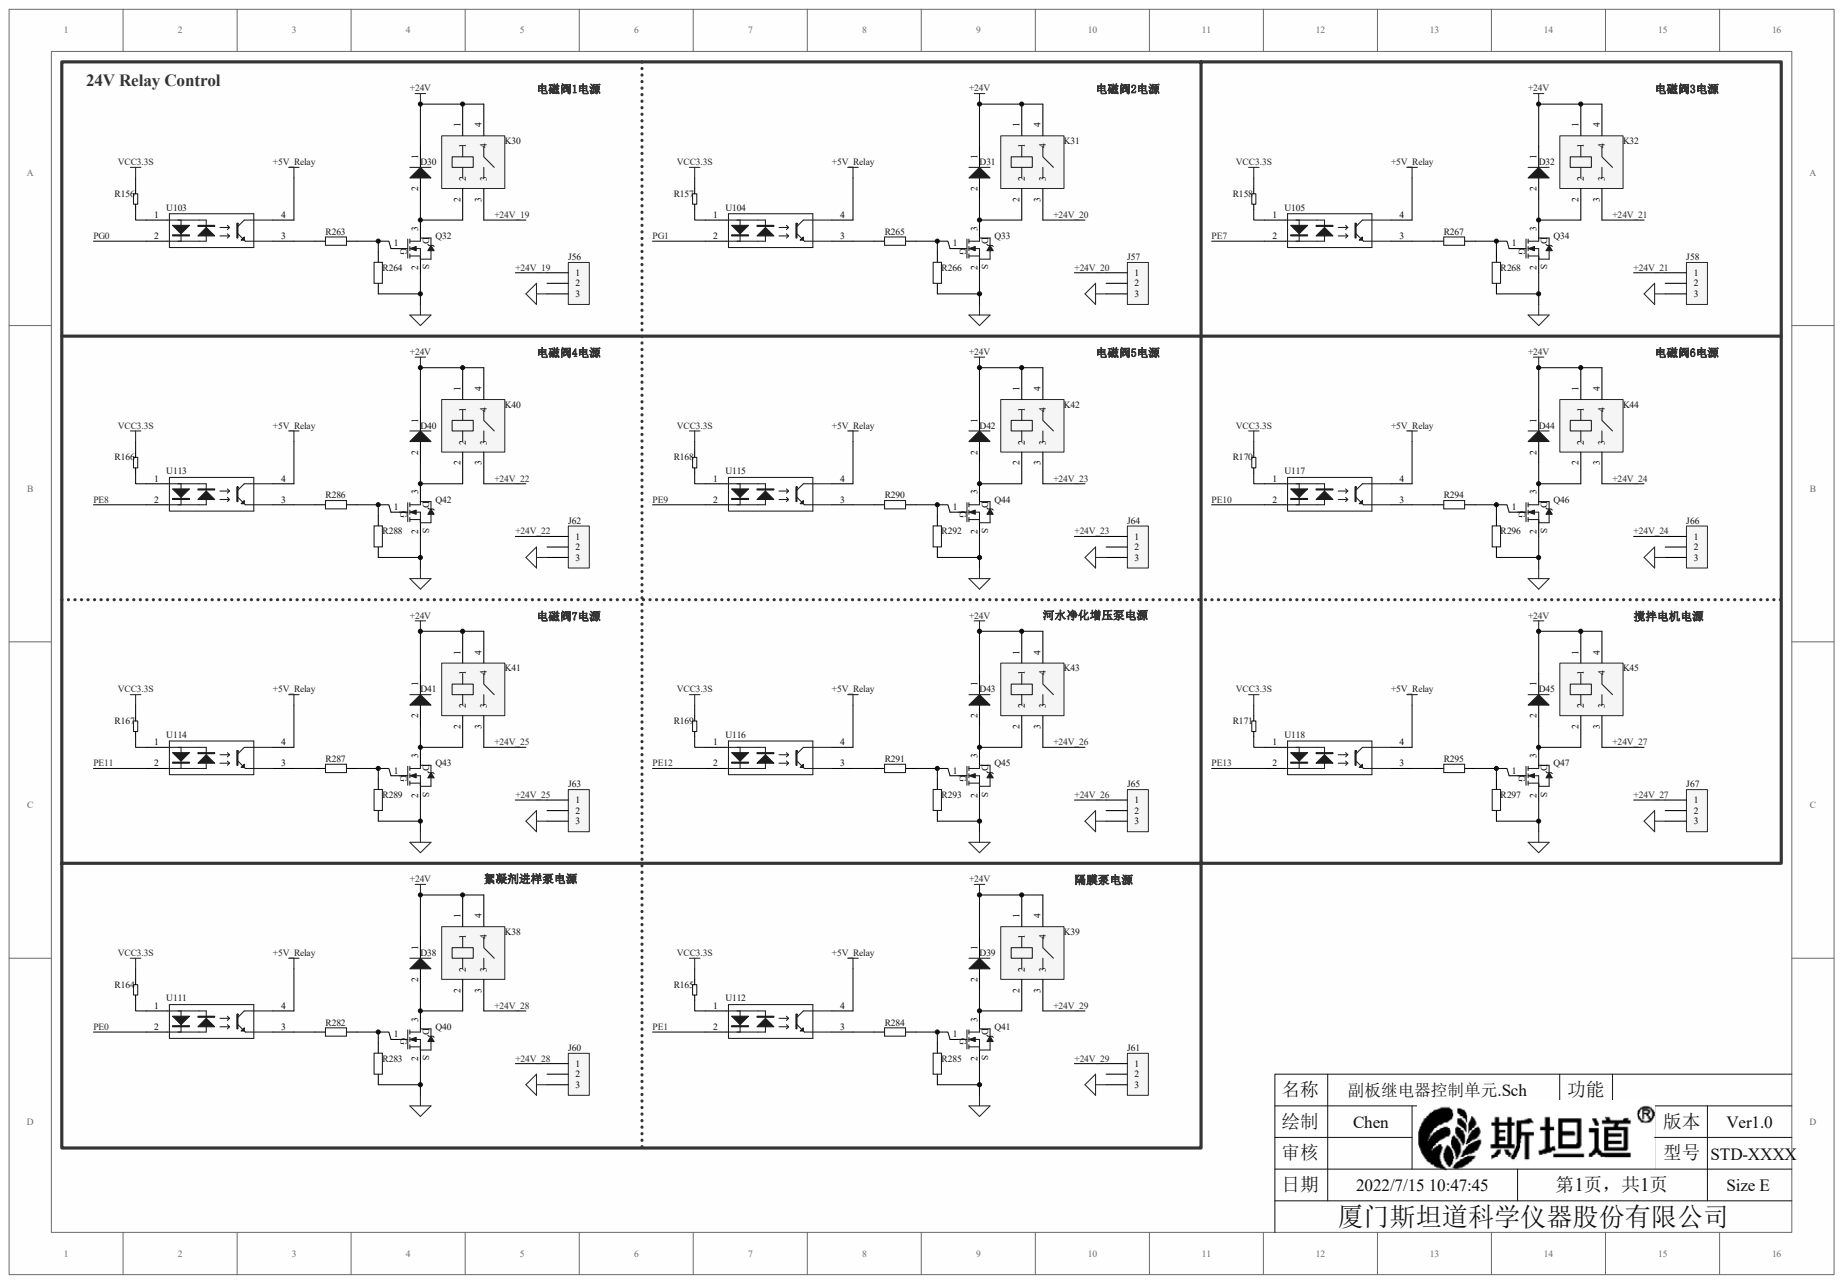
[picture p24: page 6]

# 24V Relay Control

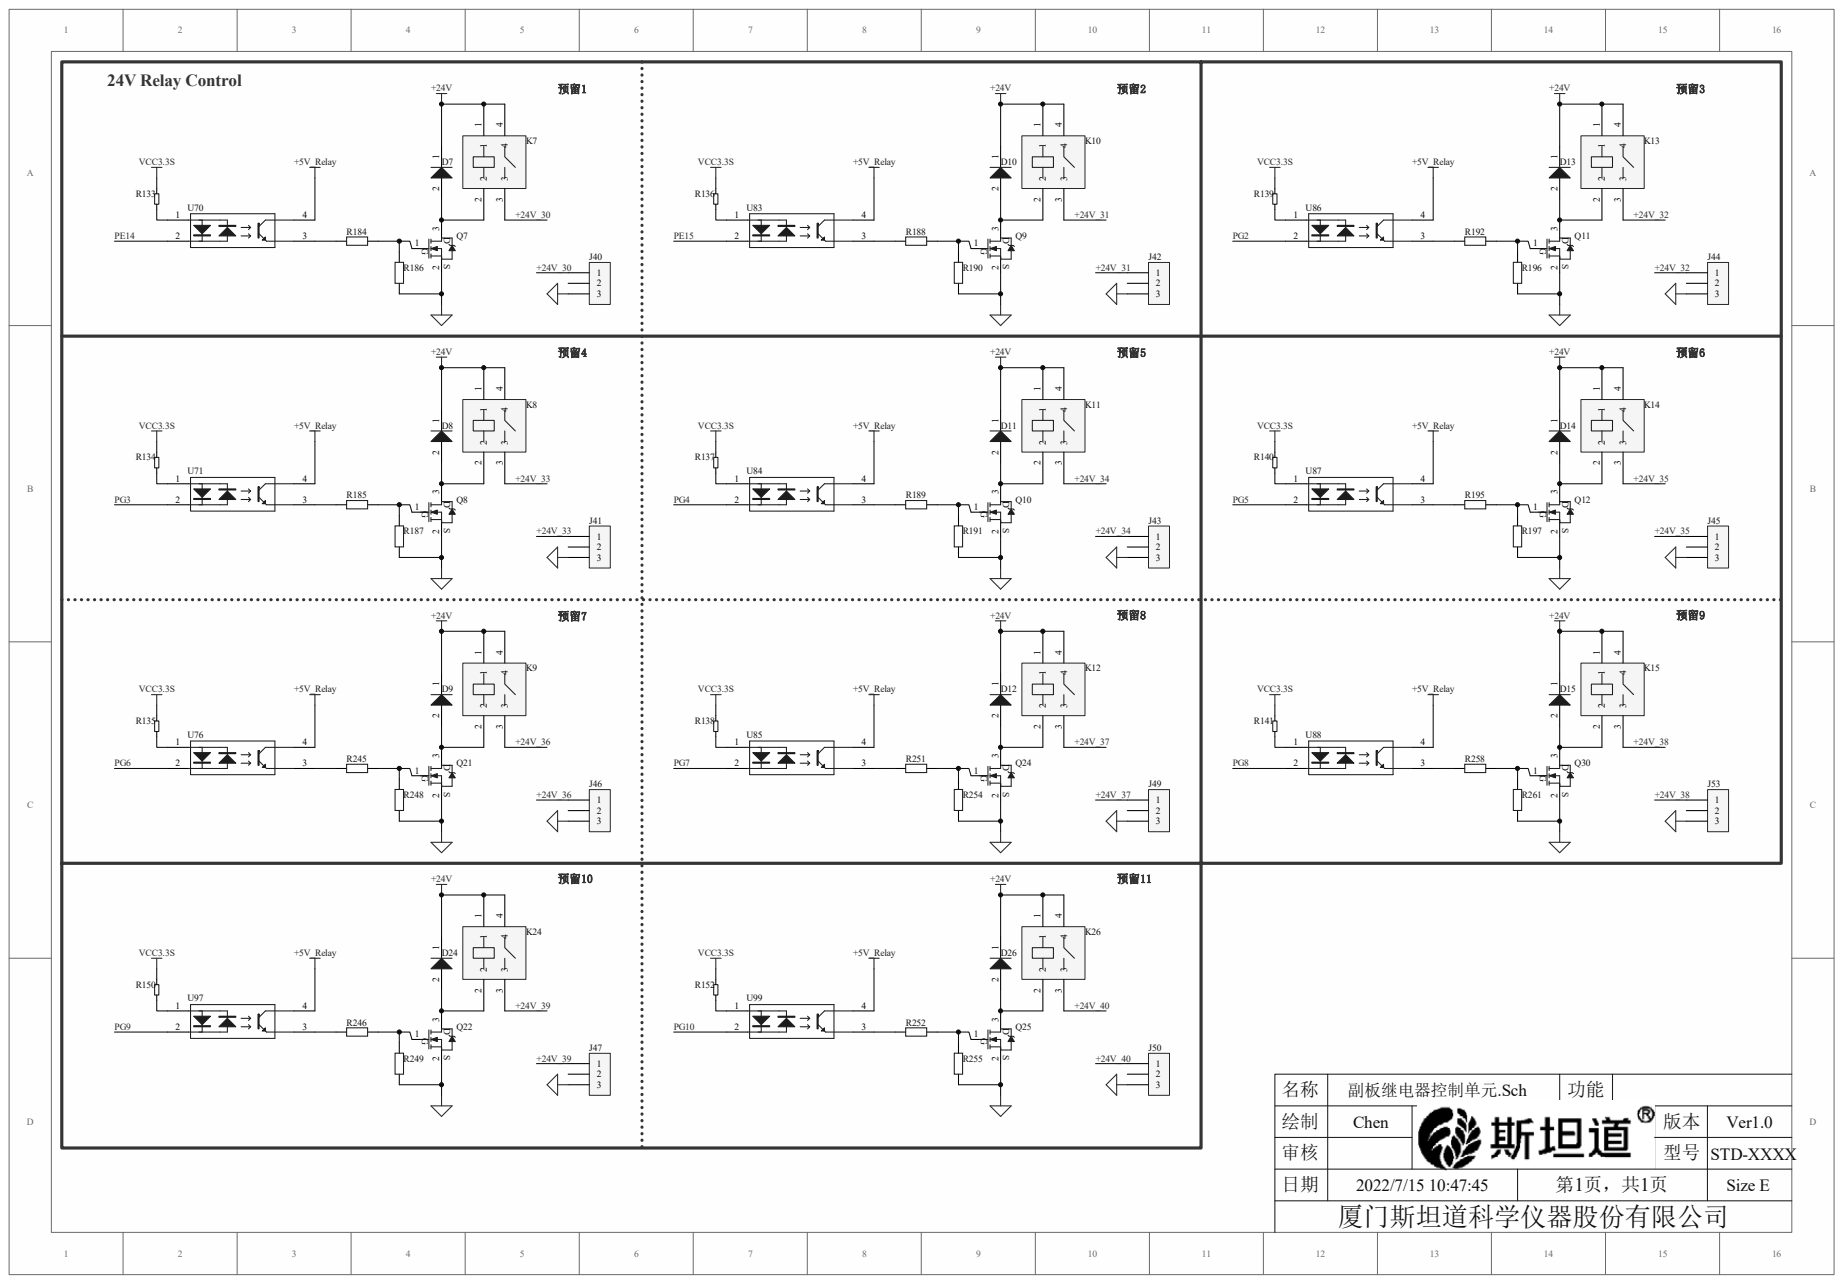
[picture p25: page 7]

# 24V Relay Control

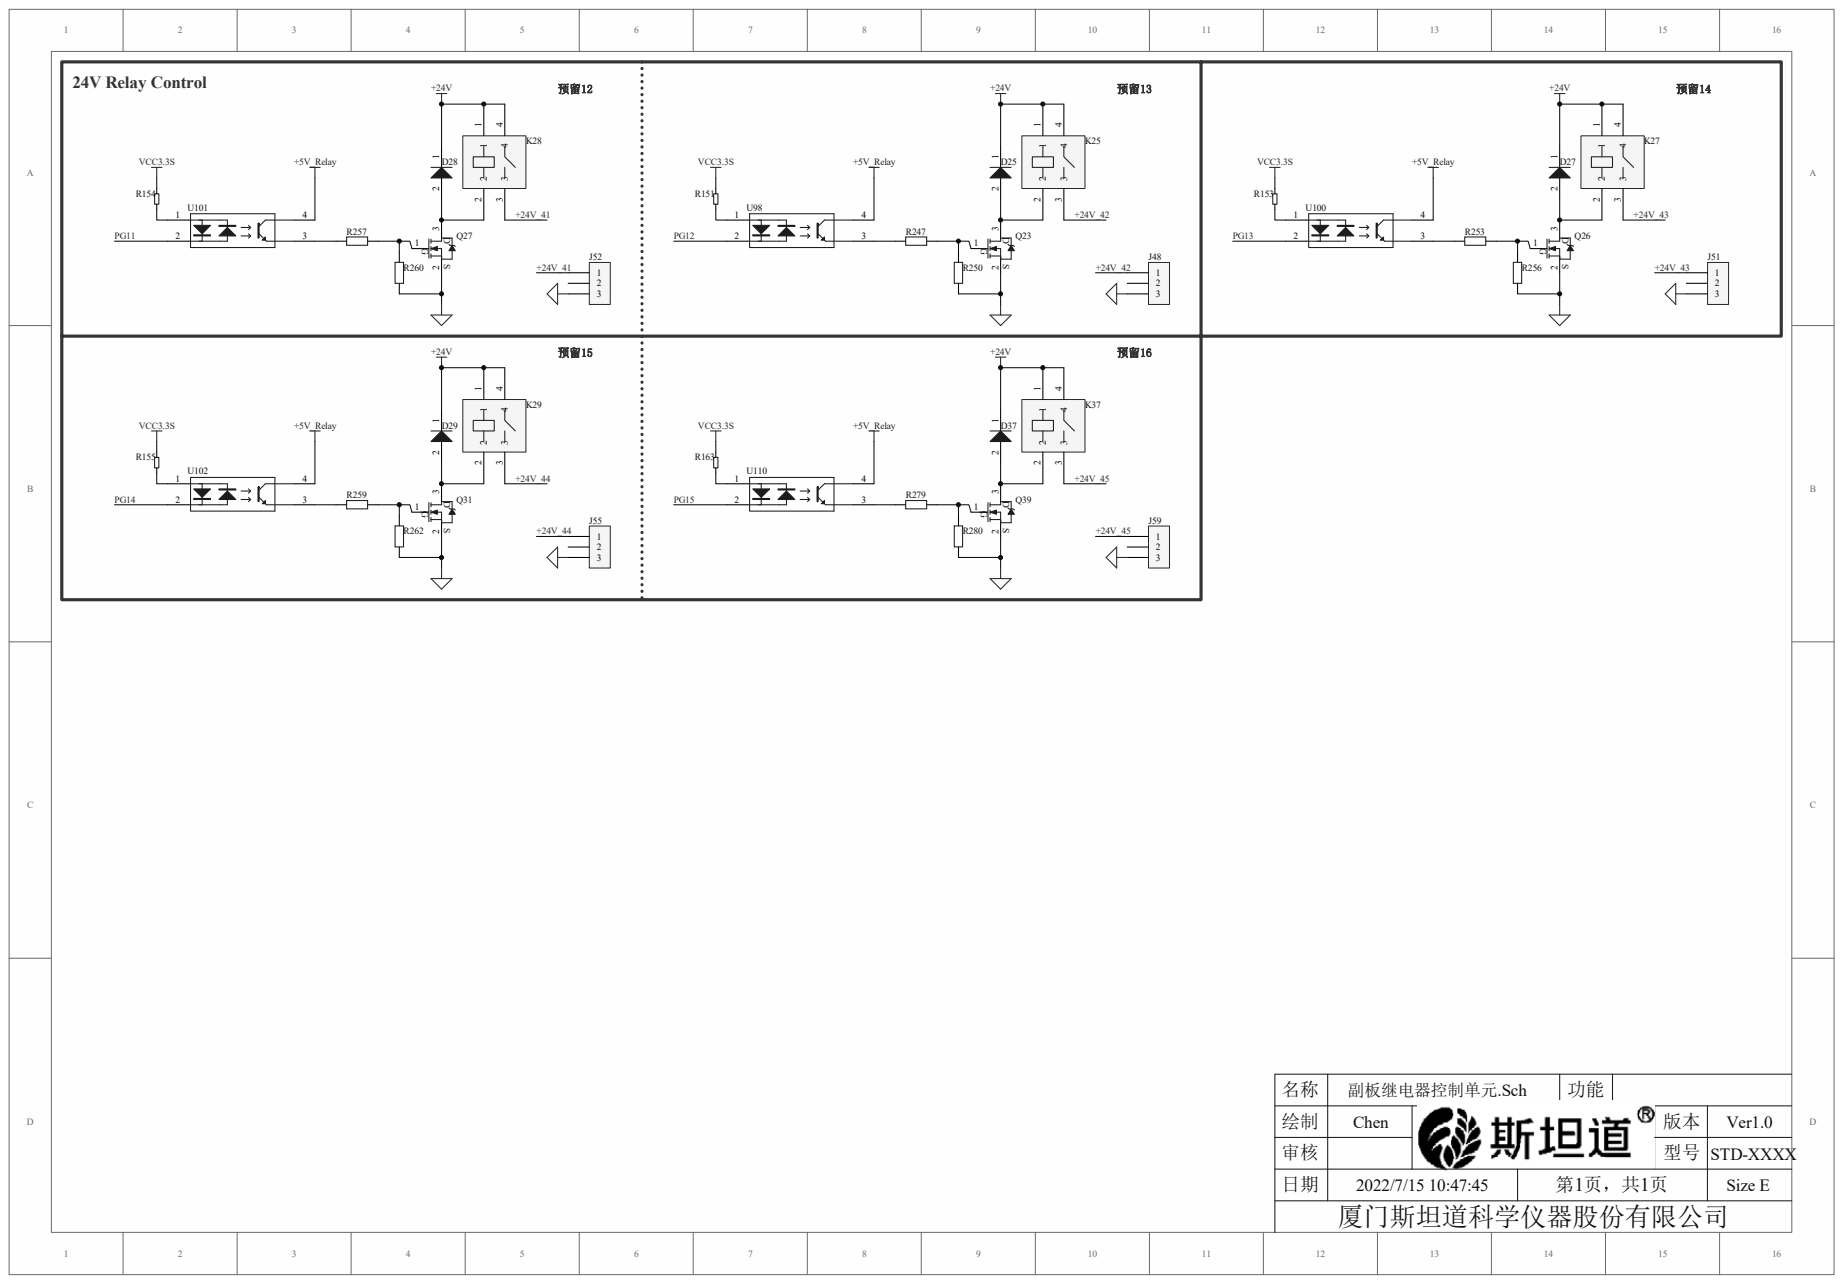
[picture p26: page 8]
