xinshuanglong/PLC2STM-Project/流程图/一体站配水系统流程图.pdf

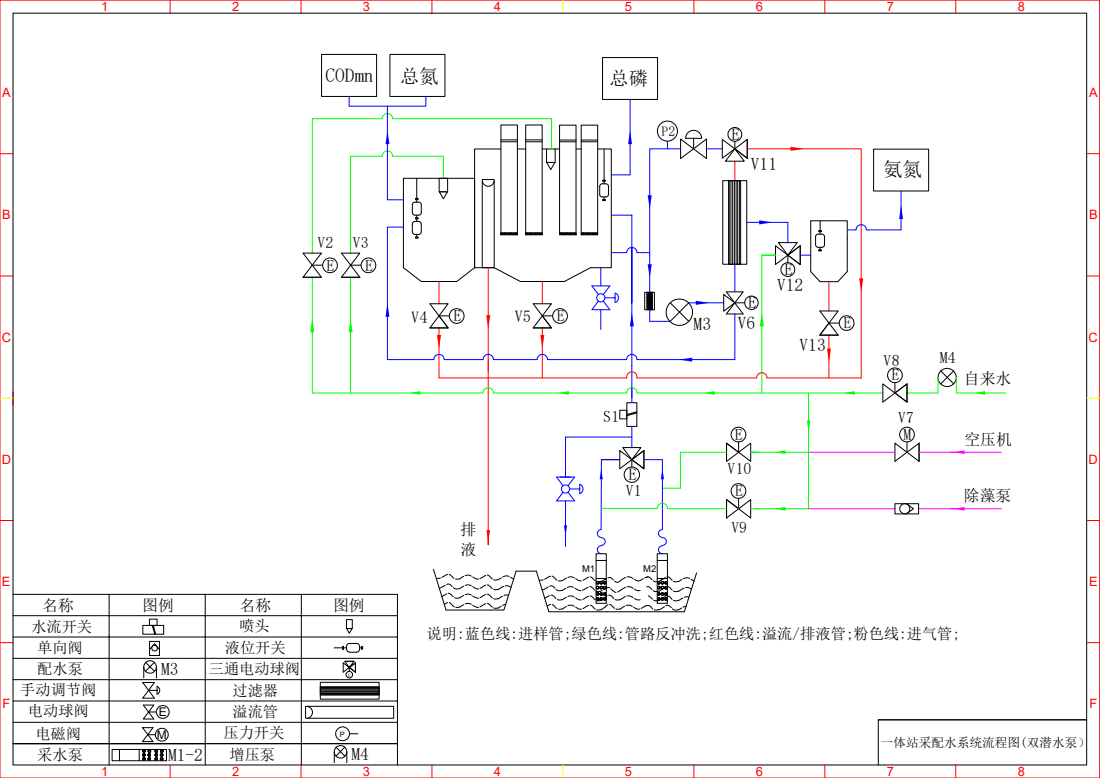
[picture p27: page 1]
自来水; 8 BACDEF; BACDEF 1; 8 单向阀 电磁阀; 三通电动球阀 电动球阀; 液位开关 手动调节阀; 过滤器 喷头 配水泵; 说明:蓝色线:进样管;绿色线:管路反冲洗;红色线:溢流/排液管;粉色线:进气管; 溢流管; S1 压力开关 水流开关; E 采水泵; 增压泵; 空压机 V7 一体站采配水系统流程图(双潜水泵） EV9 P2; 氨氮 CODmn; 除藻泵
