xinshuanglong/PLC2STM-Project/流程图/固定站采配水运行逻辑图.pdf

# 固定站/简易站采配水运行逻辑图

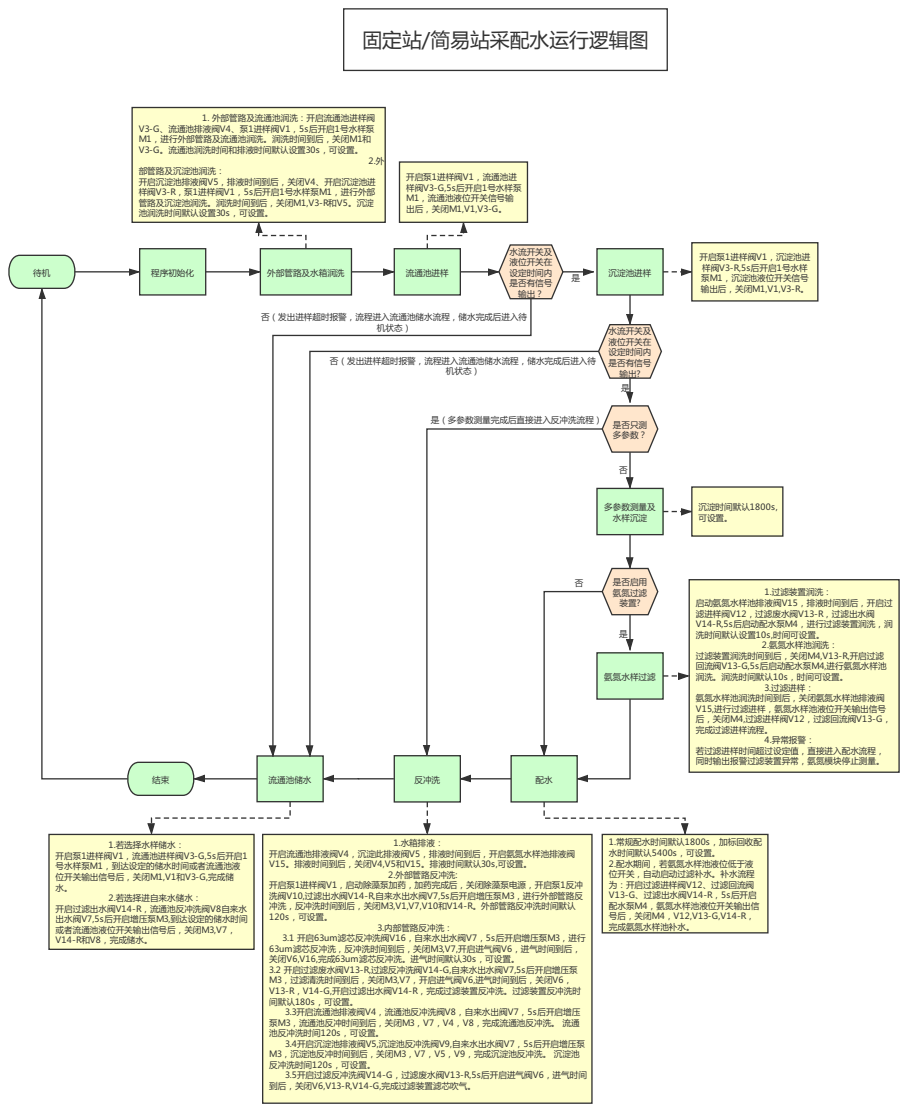
[picture p28: page 1]
程序初始化; 外部管路及水箱润洗; 1. 外部管路及流通池润洗：开启流通池进样阀 V3-G、流通池排液阀V4、泵1进样阀V1，5s后开启1号水样泵 M1，进行外部管路及流通池润洗。润洗时间到后，关闭M1和 V3-G。流通池润洗时间和排液时间默认设置30s，可设置。; 流通池进样; 开启泵1进样阀V1，流通池进 样阀V3-G,5s后开启1号水样泵 M1，流通池液位开关信号输 出后，关闭M1,V1,V3-G。; 沉淀池进样; 多参数测量及 水样沉淀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

部管路及沉淀池润洗：
开启沉淀池排液阀V5，排液时间到后，关闭V4、开启沉淀池进
样阀V3-R，泵1进样阀V1，5s后开启1号水样泵M1，进行外部
管路及沉淀池润洗。润洗时间到后，关闭M1,V3-R和V5。沉淀
池润洗时间默认设置30s，可设置。

否（发出进样超时报警，流程进入流通池储水流程，储水完成后进入待

开启流通池排液阀V4，沉淀此排液阀V5，排液时间到后，开启氨氮水样池排液阀
V15。排液时间到后，关闭V4,V5和V15。排液时间默认30s,可设置。
2.外部管路反冲洗: 开启泵1进样阀V1，启动除藻泵加药，加药完成后，关闭除藻泵电源，开启泵1反冲

洗阀V10,过滤出水阀V14-R,自来水出水阀V7,5s后开启增压泵M3，进行外部管路反
冲洗，反冲洗时间到后，关闭M3,V1,V7,V10和V14-R。外部管路反冲洗时间默认
120s，可设置。
