xinshuanglong/PLC2STM-Project/流程图/简易站配水系统流程图.pdf

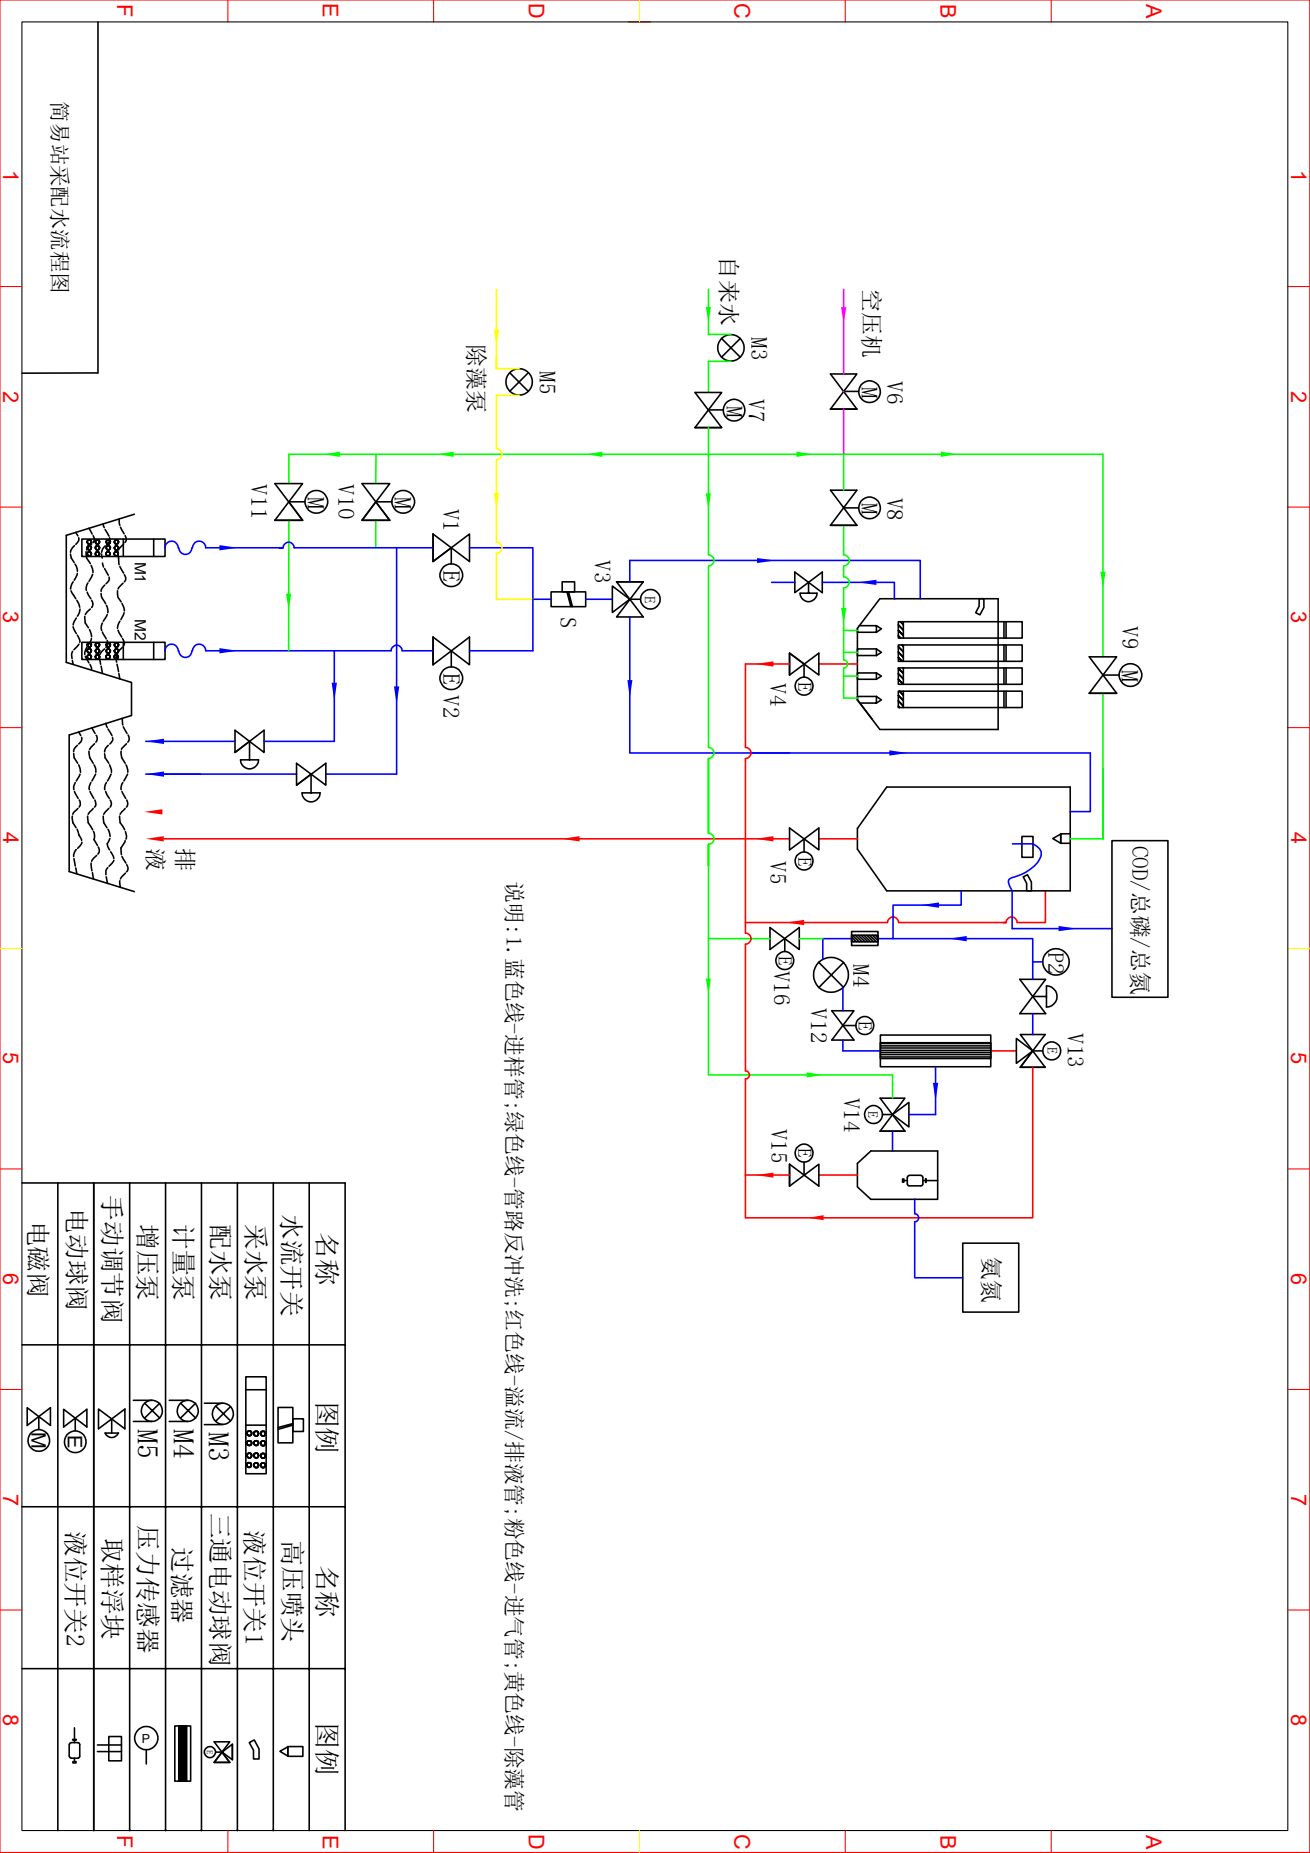
[picture p29: page 1]
自来水 M; 空压机 M; 除藻泵

V8 1 2 3 4 5 6 7 8 FEDCBA FEDCBA 1 2 3 4 5 6 7 8 P 电磁阀 ME 三通电动球阀 电动球阀 液位开关1 手动调节阀 高压喷头 配水泵 E 压力传感器 采水泵 水流开关 M4M3 计量泵 图例 图例 名称 名称 简易站采配水流程图 取样浮块 M5 增压泵 过滤器 E E 氨氮 E V5 M4 V12V13 V14V15 说明:1.蓝色线-进样管;绿色线-管路反冲洗;红色线-溢流/排液管;粉色线-进气管;黄色线-除藻管 液位开关2 E V16

V9 COD/总磷/总氮
