xinshuanglong/PLC2STM-Project/Code/C/IAP/SYSTEM/usart/usart.c

#include "sys.h"
#include "delay.h"
#include "usart.h"	
#include "bsp_fifo.h"



#include "config.h"



u8 USART1_RX_BUF[USART1_RX_LEN];      //接收缓冲,最大USART_REC_LEN个字节.
u8 USART1_TX_BUF[USART1_TX_LEN]; 

u8 USART2_RX_BUF[USART2_RX_LEN];      //接收缓冲,最大USART_REC_LEN个字节.
u8 USART2_TX_BUF[USART2_TX_LEN]; 

u8 USART3_RX_BUF[USART3_RX_LEN];      //接收缓冲,最大USART_REC_LEN个字节.
u8 USART3_TX_BUF[USART3_TX_LEN]; 

u8 UART4_RX_BUF[UART4_RX_LEN];        //接收缓冲,最大USART_REC_LEN个字节.
u8 UART4_TX_BUF[UART4_TX_LEN]; 

u8 USART6_RX_BUF[USART6_RX_LEN];      //接收缓冲,最大USART_REC_LEN个字节.
u8 USART6_TX_BUF[USART6_TX_LEN]; 
 

FIFO_Type Uart1_Rx_Fifo;										  //串口1环形FIFO结构变量						

FIFO_Type Uart2_Rx_Fifo;										  //串口2环形FIFO结构变量

FIFO_Type Uart3_Rx_Fifo;										  //串口2环形FIFO结构变量


FIFO_Type Uart4_Rx_Fifo;										  //串口4环形FIFO结构变量


FIFO_Type Uart6_Rx_Fifo;										  //串口6环形FIFO结构变量


extern u8 CmdRxSemCount;     //计数型信号量



//////////////////////////////////////////////////////////////////
//加入以下代码,支持printf函数,而不需要选择use MicroLIB	  
#if 1
#pragma import(__use_no_semihosting)             
//标准库需要的支持函数                 
struct __FILE 
{ 
	int handle; 
}; 

FILE __stdout;       
//定义_sys_exit()以避免使用半主机模式    
void _sys_exit(int x) 
{ 
	x = x; 
} 

void _ttywrch(int ch)
{
    ch=ch;
}

int fputc(int Data, FILE *f)
{   
	#if 1
		while(!USART_GetFlagStatus(DEBUG_USART,USART_FLAG_TXE));	  //USART_GetFlagStatus：得到发送状态位
																																//USART_FLAG_TXE:发送寄存器为空 1：为空；0：忙状态
		USART_SendData(DEBUG_USART,Data);						  							//发送一个字符
			 
		return Data;
	#endif 
}
#endif
 

//初始化IO 串口1 
//bound:波特率
void uart1_init(u32 bound){
   //GPIO端口设置
  GPIO_InitTypeDef GPIO_InitStructure;
	USART_InitTypeDef USART_InitStructure;
	NVIC_InitTypeDef NVIC_InitStructure;
	
	RCC_AHB1PeriphClockCmd(RCC_AHB1Periph_GPIOB,ENABLE); //使能GPIOA时钟
	RCC_APB2PeriphClockCmd(RCC_APB2Periph_USART1,ENABLE);//使能USART1时钟
 
	//串口1对应引脚复用映射
	GPIO_PinAFConfig(GPIOB,GPIO_PinSource6,GPIO_AF_USART1); //GPIOB6复用为USART1
	GPIO_PinAFConfig(GPIOB,GPIO_PinSource7,GPIO_AF_USART1); //GPIOB7复用为USART1
	
	//USART1端口配置
  GPIO_InitStructure.GPIO_Pin = GPIO_Pin_6 | GPIO_Pin_7;
	GPIO_InitStructure.GPIO_Mode = GPIO_Mode_AF;//复用功能
	GPIO_InitStructure.GPIO_Speed = GPIO_Speed_50MHz;	//速度50MHz
	GPIO_InitStructure.GPIO_OType = GPIO_OType_PP; //推挽复用输出
	GPIO_InitStructure.GPIO_PuPd = GPIO_PuPd_UP; //上拉
	GPIO_Init(GPIOB,&GPIO_InitStructure);

   //USART1 初始化设置
	USART_InitStructure.USART_BaudRate = bound;//波特率设置
	USART_InitStructure.USART_WordLength = USART_WordLength_8b;//字长为8位数据格式
	USART_InitStructure.USART_StopBits = USART_StopBits_1;//一个停止位
	USART_InitStructure.USART_Parity = USART_Parity_No;//无奇偶校验位
	USART_InitStructure.USART_HardwareFlowControl = USART_HardwareFlowControl_None;//无硬件数据流控制
	USART_InitStructure.USART_Mode = USART_Mode_Rx | USART_Mode_Tx;	//收发模式
  USART_Init(USART1, &USART_InitStructure); //初始化串口1
	
	USART_ITConfig(USART1, USART_IT_IDLE , ENABLE);//使能空闲中断
  //USART_ITConfig(USART1, USART_IT_TC , ENABLE);//使能发送完成中断
	USART_DMACmd(USART1, USART_DMAReq_Tx|USART_DMAReq_Rx, ENABLE);//支持DMA 发送和接收
	USART_Cmd(USART1, ENABLE);									//使能串口1
		
	//USART_ClearFlag(USART1, USART_FLAG_TC);

	//Usart1 NVIC 配置
  NVIC_InitStructure.NVIC_IRQChannel = USART1_IRQn;//串口1中断通道
	NVIC_InitStructure.NVIC_IRQChannelPreemptionPriority=5;//抢占优先级3
	NVIC_InitStructure.NVIC_IRQChannelSubPriority =0;		//子优先级3
	NVIC_InitStructure.NVIC_IRQChannelCmd = ENABLE;			//IRQ通道使能
	NVIC_Init(&NVIC_InitStructure);	//根据指定的参数初始化VIC寄存器、
}


void uart2_init(u32 bound)
{
	GPIO_InitTypeDef GPIO_InitStructure;
	USART_InitTypeDef USART_InitStructure;
	NVIC_InitTypeDef NVIC_InitStructure;
	
	RCC_AHB1PeriphClockCmd(RCC_AHB1Periph_GPIOA,ENABLE); //使能GPIOA时钟 
	RCC_APB1PeriphClockCmd(RCC_APB1Periph_USART2,ENABLE);//使能USART2时钟
	
  //串口2引脚复用映射
	GPIO_PinAFConfig(GPIOA,GPIO_PinSource2,GPIO_AF_USART2); //GPIOA2复用为USART2
	GPIO_PinAFConfig(GPIOA,GPIO_PinSource3,GPIO_AF_USART2); //GPIOA3复用为USART2 
  
	GPIO_InitStructure.GPIO_Mode = GPIO_Mode_AF;//复用功能
	GPIO_InitStructure.GPIO_Speed = GPIO_Speed_100MHz;	//速度100MHz
	GPIO_InitStructure.GPIO_OType = GPIO_OType_PP; //推挽复用输出
	GPIO_InitStructure.GPIO_PuPd = GPIO_PuPd_UP; //上拉
	GPIO_InitStructure.GPIO_Pin = GPIO_Pin_2; //GPIOA2与GPIOA3
	GPIO_Init(GPIOA,&GPIO_InitStructure); //初始化PA2，PA3
	
	GPIO_InitStructure.GPIO_Mode = GPIO_Mode_AF;//复用功能
	GPIO_InitStructure.GPIO_Speed = GPIO_Speed_100MHz;	//速度100MHz
	GPIO_InitStructure.GPIO_OType = GPIO_OType_PP; //推挽复用输出
	GPIO_InitStructure.GPIO_PuPd = GPIO_PuPd_UP; //上拉
	GPIO_InitStructure.GPIO_Pin = GPIO_Pin_3; //GPIOA2与GPIOA3
	GPIO_Init(GPIOA,&GPIO_InitStructure); //初始化PA2，PA3 
	
   //USART2 初始化设置
	USART_InitStructure.USART_BaudRate = bound;//波特率设置
	USART_InitStructure.USART_WordLength = USART_WordLength_8b;//字长为8位数据格式
	USART_InitStructure.USART_StopBits = USART_StopBits_1;//一个停止位
	USART_InitStructure.USART_Parity = USART_Parity_No;//无奇偶校验位
	USART_InitStructure.USART_HardwareFlowControl = USART_HardwareFlowControl_None;//无硬件数据流控制
	USART_InitStructure.USART_Mode = USART_Mode_Rx | USART_Mode_Tx;	//收发模式
  USART_Init(USART2, &USART_InitStructure); //初始化串口2
	
	USART_ITConfig(USART2, USART_IT_IDLE , ENABLE);//使能空闲中断
  //USART_ITConfig(USART2, USART_IT_TC , ENABLE);//使能发送完成中断
	USART_DMACmd(USART2, USART_DMAReq_Tx|USART_DMAReq_Rx, ENABLE);//支持DMA 发送和接收
	USART_Cmd(USART2, ENABLE);  //使能串口 2 
  //USART_ClearFlag(USART2, USART_FLAG_TC);

  //USART_ITConfig(USART2, USART_IT_RXNE, ENABLE);//开启接受中断

	//Usart2 NVIC 配置
  NVIC_InitStructure.NVIC_IRQChannel = USART2_IRQn;
	NVIC_InitStructure.NVIC_IRQChannelPreemptionPriority=4;//抢占优先级2
	NVIC_InitStructure.NVIC_IRQChannelSubPriority =0;		//子优先级3
	NVIC_InitStructure.NVIC_IRQChannelCmd = ENABLE;			//IRQ通道使能
	NVIC_Init(&NVIC_InitStructure);	//根据指定的参数初始化VIC寄存器、
				 
}

void uart3_init(u32 bound)
{
	GPIO_InitTypeDef GPIO_InitStructure;
	USART_InitTypeDef USART_InitStructure;
	NVIC_InitTypeDef NVIC_InitStructure;
	
	RCC_AHB1PeriphClockCmd(RCC_AHB1Periph_GPIOB,ENABLE); //使能GPIOA时钟  
	RCC_AHB1PeriphClockCmd(RCC_AHB1Periph_GPIOD,ENABLE);	//使能GPIOD时钟
	RCC_APB1PeriphClockCmd(RCC_APB1Periph_USART3,ENABLE);//使能USART3时钟

  //串口3引脚复用映射
	GPIO_PinAFConfig(GPIOB,GPIO_PinSource10,GPIO_AF_USART3); //GPIOB10复用为USART3
	GPIO_PinAFConfig(GPIOB,GPIO_PinSource11,GPIO_AF_USART3); //GPIOB11复用为USART3 
  
	GPIO_InitStructure.GPIO_Mode = GPIO_Mode_AF;//复用功能
	GPIO_InitStructure.GPIO_Speed = GPIO_Speed_100MHz;	//速度100MHz
	GPIO_InitStructure.GPIO_OType = GPIO_OType_PP; //推挽复用输出
	GPIO_InitStructure.GPIO_PuPd = GPIO_PuPd_UP; //上拉
	GPIO_InitStructure.GPIO_Pin = GPIO_Pin_10; //GPIOB10与GPIOB11
	GPIO_Init(GPIOB,&GPIO_InitStructure); //初始化PB10，PB11
	
	GPIO_InitStructure.GPIO_Mode = GPIO_Mode_AF;//复用功能
	GPIO_InitStructure.GPIO_Speed = GPIO_Speed_100MHz;	//速度100MHz
	GPIO_InitStructure.GPIO_OType = GPIO_OType_PP; //推挽复用输出
	GPIO_InitStructure.GPIO_PuPd = GPIO_PuPd_UP; //上拉
	GPIO_InitStructure.GPIO_Pin = GPIO_Pin_11; //GPIOB10与GPIOB11
	GPIO_Init(GPIOB,&GPIO_InitStructure); //初始化PB10，PB11
	
  //USART3 初始化设置
	USART_InitStructure.USART_BaudRate = bound;//波特率设置
	USART_InitStructure.USART_WordLength = USART_WordLength_8b;//字长为8位数据格式
	USART_InitStructure.USART_StopBits = USART_StopBits_1;//一个停止位
	USART_InitStructure.USART_Parity = USART_Parity_No;//无奇偶校验位
	USART_InitStructure.USART_HardwareFlowControl = USART_HardwareFlowControl_None;//无硬件数据流控制
	USART_InitStructure.USART_Mode = USART_Mode_Rx | USART_Mode_Tx;	//收发模式
  USART_Init(USART3, &USART_InitStructure); //初始化串口3
	
	USART_ITConfig(USART3, USART_IT_IDLE , ENABLE);//使能空闲中断
  //USART_ITConfig(USART2, USART_IT_TC , ENABLE);//使能发送完成中断
	USART_DMACmd(USART3, USART_DMAReq_Tx|USART_DMAReq_Rx, ENABLE);//支持DMA 发送和接收
	USART_Cmd(USART3, ENABLE);  //使能串口 3 
  //USART_ClearFlag(USART2, USART_FLAG_TC);

  //USART_ITConfig(USART2, USART_IT_RXNE, ENABLE);//开启接受中断
	
  /* Enable DMA1_Stream3 Interrupt */
  /* NVIC_InitStructure.NVIC_IRQChannel = DMA1_Stream3_IRQn;
  NVIC_InitStructure.NVIC_IRQChannelPreemptionPriority = 1;
  NVIC_InitStructure.NVIC_IRQChannelSubPriority = 2;
  NVIC_InitStructure.NVIC_IRQChannelCmd = ENABLE;
  NVIC_Init(&NVIC_InitStructure); */
	
	//Usart3 NVIC 配置
  NVIC_InitStructure.NVIC_IRQChannel = USART3_IRQn;
	NVIC_InitStructure.NVIC_IRQChannelPreemptionPriority=5;//抢占优先级2
	NVIC_InitStructure.NVIC_IRQChannelSubPriority =0;		//子优先级3
	NVIC_InitStructure.NVIC_IRQChannelCmd = ENABLE;			//IRQ通道使能
	NVIC_Init(&NVIC_InitStructure);	//根据指定的参数初始化VIC寄存器、 
}

//初始化IO 串口4 
//bound:波特率
void uart4_init(u32 bound){
   //GPIO端口设置
  GPIO_InitTypeDef GPIO_InitStructure;
	USART_InitTypeDef USART_InitStructure;
	NVIC_InitTypeDef NVIC_InitStructure;
	
	//RCC_AHB1PeriphClockCmd(RCC_AHB1Periph_GPIOA,ENABLE);	//使能GPIOA时钟
	RCC_AHB1PeriphClockCmd(RCC_AHB1Periph_GPIOC,ENABLE);	//使能GPIOC时钟
	RCC_APB1PeriphClockCmd(RCC_APB1Periph_UART4,ENABLE);	//使能UART4时钟
 
	//串口4对应引脚复用映射
	GPIO_PinAFConfig(GPIOA,GPIO_PinSource0,GPIO_AF_UART4); //GPIOA0复用为UART4
	GPIO_PinAFConfig(GPIOA,GPIO_PinSource1,GPIO_AF_UART4); //GPIOA1复用为UART4
	
	//UART4端口配置
  GPIO_InitStructure.GPIO_Pin = GPIO_Pin_0 ; //GPIOA0与GPIOA1
	GPIO_InitStructure.GPIO_Mode = GPIO_Mode_AF;//复用功能
	GPIO_InitStructure.GPIO_Speed = GPIO_Speed_50MHz;	//速度50MHz
	GPIO_InitStructure.GPIO_OType = GPIO_OType_PP; //推挽复用输出
	GPIO_InitStructure.GPIO_PuPd = GPIO_PuPd_UP; //上拉
	GPIO_Init(GPIOA,&GPIO_InitStructure); //初始化PA0，PA1
	
	GPIO_InitStructure.GPIO_Pin = GPIO_Pin_1; //GPIOA0与GPIOA1
	GPIO_Init(GPIOA,&GPIO_InitStructure); //初始化PA0，PA1

   //UART4 初始化设置
	USART_InitStructure.USART_BaudRate = bound;//波特率设置
	USART_InitStructure.USART_WordLength = USART_WordLength_8b;//字长为8位数据格式
	USART_InitStructure.USART_StopBits = USART_StopBits_1;//一个停止位
	USART_InitStructure.USART_Parity = USART_Parity_No;//无奇偶校验位
	USART_InitStructure.USART_HardwareFlowControl = USART_HardwareFlowControl_None;//无硬件数据流控制
	USART_InitStructure.USART_Mode = USART_Mode_Rx | USART_Mode_Tx;	//收发模式
  USART_Init(UART4, &USART_InitStructure); //初始化串口1
	
	USART_ITConfig(UART4, USART_IT_IDLE , ENABLE);//使能空闲中断
  //USART_ITConfig(UART4, USART_IT_TC , ENABLE);//使能发送完成中断
	USART_DMACmd(UART4, USART_DMAReq_Tx|USART_DMAReq_Rx, ENABLE);//支持DMA 发送和接收
	USART_Cmd(UART4, ENABLE);									//使能串口4 

	//Usart1 NVIC 配置
  NVIC_InitStructure.NVIC_IRQChannel = UART4_IRQn;//串口4中断通道
	NVIC_InitStructure.NVIC_IRQChannelPreemptionPriority=3;//抢占优先级3
	NVIC_InitStructure.NVIC_IRQChannelSubPriority =0;		//子优先级3
	NVIC_InitStructure.NVIC_IRQChannelCmd = ENABLE;			//IRQ通道使能
	NVIC_Init(&NVIC_InitStructure);	//根据指定的参数初始化VIC寄存器、
}

void uart6_init(u32 bound)
{
	GPIO_InitTypeDef GPIO_InitStructure;
	USART_InitTypeDef USART_InitStructure;
	NVIC_InitTypeDef NVIC_InitStructure;
	 
	RCC_AHB1PeriphClockCmd(RCC_AHB1Periph_GPIOC,ENABLE); //使能GPIOC时钟  
	RCC_APB2PeriphClockCmd(RCC_APB2Periph_USART6,ENABLE);//使能USART6时钟
	
  //串口6引脚复用映射
	GPIO_PinAFConfig(GPIOC,GPIO_PinSource6,GPIO_AF_USART6); //GPIOC6复用为USART6
	GPIO_PinAFConfig(GPIOC,GPIO_PinSource7,GPIO_AF_USART6); //GPIOC7复用为USART6 
  
	GPIO_InitStructure.GPIO_Mode = GPIO_Mode_AF;//复用功能
	GPIO_InitStructure.GPIO_Speed = GPIO_Speed_100MHz;	//速度100MHz
	GPIO_InitStructure.GPIO_OType = GPIO_OType_PP; //推挽复用输出
	GPIO_InitStructure.GPIO_PuPd = GPIO_PuPd_UP; //上拉
	GPIO_InitStructure.GPIO_Pin = GPIO_Pin_6; //GPIOC6与GPIOC7
	GPIO_Init(GPIOC,&GPIO_InitStructure); //初始化PC6，PC7
	
	GPIO_InitStructure.GPIO_Pin = GPIO_Pin_7; //GPIOC6与GPIOC7
	GPIO_Init(GPIOC,&GPIO_InitStructure); //初始化PC6，PC7 
	
   //USART6 初始化设置
	USART_InitStructure.USART_BaudRate = bound;//波特率设置
	USART_InitStructure.USART_WordLength = USART_WordLength_8b;//字长为8位数据格式
	USART_InitStructure.USART_StopBits = USART_StopBits_1;//一个停止位
	USART_InitStructure.USART_Parity = USART_Parity_No;//无奇偶校验位
	USART_InitStructure.USART_HardwareFlowControl = USART_HardwareFlowControl_None;//无硬件数据流控制
	USART_InitStructure.USART_Mode = USART_Mode_Rx | USART_Mode_Tx;	//收发模式
  USART_Init(USART6, &USART_InitStructure); //初始化串口2
	
	USART_ITConfig(USART6, USART_IT_IDLE , ENABLE);//使能空闲中断
	//USART_ITConfig(USART6, USART_IT_TC , ENABLE);//使能发送完成中断
	USART_DMACmd(USART6, USART_DMAReq_Tx|USART_DMAReq_Rx, ENABLE);//支持DMA 发送和接收
	USART_Cmd(USART6, ENABLE);  //使能串口 2 
	//USART_ClearFlag(USART6, USART_FLAG_TC);

	//USART_ITConfig(USART6, USART_IT_RXNE, ENABLE);//开启接受中断

	//Usart2 NVIC 配置
  NVIC_InitStructure.NVIC_IRQChannel = USART6_IRQn;
	NVIC_InitStructure.NVIC_IRQChannelPreemptionPriority=2;//抢占优先级2
	NVIC_InitStructure.NVIC_IRQChannelSubPriority =0;		//子优先级3
	NVIC_InitStructure.NVIC_IRQChannelCmd = ENABLE;			//IRQ通道使能
	NVIC_Init(&NVIC_InitStructure);	//根据指定的参数初始化VIC寄存器		 
}
 
void UART1_INIT(void)
{	
	uart1_init(115200);
	/*****发送***************/
	MYDMA_Send_Config(DMA2_Stream7,DMA_Channel_4,(u32)&USART1->DR,(u32)USART1_TX_BUF,0);//DMA2,STEAM7,CH4,外设为串口1,存储器为SendBuff,长度为:SEND_BUF_SIZE.
	/*****接收***************/
	MYDMA_Receive_Config(DMA2_Stream5,DMA_Channel_4,(u32)&USART1->DR,(u32)USART1_RX_BUF,USART1_RX_LEN);//DMA2,STEAM7,CH4,外设为串口1,存储器为SendBuff,长度为:SEND_BUF_SIZE.
  //接收FIFO初始化
	Fifo_Init(&Uart1_Rx_Fifo,USART1_RX_BUF,USART1_RX_LEN);//FIFO初始化，接收缓存以环形FIFO形式管理
}

void UART2_INIT(void)
{	
	uart2_init(115200);
	/*****发送***************/
	MYDMA_Send_Config(DMA1_Stream6,DMA_Channel_4,(u32)&USART2->DR,(u32)USART2_TX_BUF,0);//DMA2,STEAM7,CH4,外设为串口1,存储器为SendBuff,长度为:SEND_BUF_SIZE.
	/*****接收***************/
	MYDMA_Receive_Config(DMA1_Stream5,DMA_Channel_4,(u32)&USART2->DR,(u32)USART2_RX_BUF,USART2_RX_LEN);//DMA2,STEAM7,CH4,外设为串口1,存储器为SendBuff,长度为:SEND_BUF_SIZE.
  //接收FIFO初始化
  Fifo_Init(&Uart2_Rx_Fifo,USART2_RX_BUF,USART2_RX_LEN);
}

void UART3_INIT(void)
{
	uart3_init(115200);
	/*****发送***************/
	MYDMA_Send_Config(DMA1_Stream3,DMA_Channel_4,(u32)&USART3->DR,(u32)USART3_TX_BUF,0);//DMA2,STEAM7,CH4,外设为串口1,存储器为SendBuff,长度为:SEND_BUF_SIZE.
	/*****接收***************/
	MYDMA_Receive_Config(DMA1_Stream1,DMA_Channel_4,(u32)&USART3->DR,(u32)USART3_RX_BUF,USART3_RX_LEN);//DMA2,STEAM7,CH4,外设为串口1,存储器为SendBuff,长度为:SEND_BUF_SIZE.
  //接收FIFO初始化
  Fifo_Init(&Uart3_Rx_Fifo,USART3_RX_BUF,USART3_RX_LEN);
}

void UART4_INIT(void)
{
	uart4_init(115200);
	/*****发送***************/
	MYDMA_Send_Config(DMA1_Stream4,DMA_Channel_4,(u32)&UART4->DR,(u32)UART4_TX_BUF,0);//DMA2,STEAM7,CH4,外设为串口1,存储器为SendBuff,长度为:SEND_BUF_SIZE.
	/*****接收***************/
	MYDMA_Receive_Config(DMA1_Stream2,DMA_Channel_4,(u32)&UART4->DR,(u32)UART4_RX_BUF,UART4_RX_LEN);//DMA2,STEAM7,CH4,外设为串口1,存储器为SendBuff,长度为:SEND_BUF_SIZE.
  //接收FIFO初始化
  Fifo_Init(&Uart4_Rx_Fifo,UART4_RX_BUF,UART4_RX_LEN);
}

void UART6_INIT(void)
{
	uart6_init(57600);
	/*****发送***************/
	MYDMA_Send_Config(DMA2_Stream6,DMA_Channel_5,(u32)&USART6->DR,(u32)USART6_TX_BUF,0);//DMA2,STEAM7,CH4,外设为串口1,存储器为SendBuff,长度为:SEND_BUF_SIZE.
	/*****接收***************/
	MYDMA_Receive_Config(DMA2_Stream2,DMA_Channel_5,(u32)&USART6->DR,(u32)USART6_RX_BUF,USART6_RX_LEN);//DMA2,STEAM7,CH4,外设为串口1,存储器为SendBuff,长度为:SEND_BUF_SIZE.
  //接收FIFO初始化
  Fifo_Init(&Uart6_Rx_Fifo,USART6_RX_BUF,USART6_RX_LEN);
}



void Uart_1_Send(const uint8_t* buf, uint16_t len)
{
	u8 i=0;
	if(len == 0)
	{
		return;
	}
	
	DMA_Cmd(DMA2_Stream7, DISABLE);                                        //关闭DMA传输 
	while (DMA_GetCmdStatus(DMA2_Stream7) != DISABLE){}	                   //确保DMA可以被设置  
	DMA_SetCurrDataCounter(DMA2_Stream7,len);        										   //数据传输量  
	DMA2_Stream7->M0AR = (uint32_t)buf;                                    //传输数组
	DMA_Cmd(DMA2_Stream7, ENABLE);                                         //开启DMA传输 
	
	for(i=0;i<200;i++)
	{
		if(DMA_GetFlagStatus(DMA2_Stream7,DMA_FLAG_TCIF7)!=RESET)//等待DMA2_Steam7传输完成
		{ 
			DMA_ClearFlag(DMA2_Stream7,DMA_FLAG_TCIF7);//清除DMA2_Steam7传输完成标志	
			break; 
		}
		delay_ms(10);
	}
	DMA_Cmd(DMA2_Stream7, DISABLE);                             //关闭串口发送通道
}


void Uart_2_Send(const uint8_t* buf, uint16_t len)
{
	u8 i=0;
	if(len == 0)
	{
		return;
	}

	DMA_Cmd(DMA1_Stream6, DISABLE);                                        //关闭DMA传输 
	while (DMA_GetCmdStatus(DMA1_Stream6) != DISABLE){}	                   //确保DMA可以被设置  
	DMA_SetCurrDataCounter(DMA1_Stream6,len);        										   //数据传输量  
	DMA1_Stream6->M0AR = (uint32_t)buf;                                    //传输数组
	DMA_Cmd(DMA1_Stream6, ENABLE);                                         //开启DMA传输 
	 
	for(i=0;i<200;i++)
	{
		if(DMA_GetFlagStatus(DMA1_Stream6,DMA_FLAG_TCIF6)!=RESET)//等待DMA2_Steam7传输完成
		{ 
			DMA_ClearFlag(DMA1_Stream6,DMA_FLAG_TCIF6);            //清除DMA2_Steam7传输完成标
		  break;
		}
		delay_ms(10);
	}
	DMA_Cmd(DMA1_Stream6, DISABLE);  //关闭串口发送通道
} 

void Uart_3_Send(const uint8_t* buf, uint16_t len)
{
	u8 i=0;
	if(len == 0)
	{
		return;
	}
	 
	DMA_Cmd(DMA1_Stream3, DISABLE);                                        //关闭DMA传输 
	while (DMA_GetCmdStatus(DMA1_Stream3) != DISABLE){}	                   //确保DMA可以被设置  
	DMA_SetCurrDataCounter(DMA1_Stream3,len);        										   //数据传输量  
	DMA1_Stream3->M0AR = (uint32_t)buf;                                    //传输数组
	DMA_Cmd(DMA1_Stream3, ENABLE);                                         //开启DMA传输 
	 
	for(i=0;i<200;i++)
	{
		if(DMA_GetFlagStatus(DMA1_Stream3,DMA_FLAG_TCIF3)!=RESET)//等待DMA1_Steam3传输完成
		{ 
			DMA_ClearFlag(DMA1_Stream3,DMA_FLAG_TCIF3);            //清除DMA1_Steam3传输完成标
		  break;
		}
		delay_ms(10);
	}
	DMA_Cmd(DMA1_Stream3, DISABLE);  //关闭串口发送通道 
} 

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
	} 
}	


//蓝牙串口中断
void USART6_IRQHandler(void)
{
	if(USART_GetITStatus(USART6,USART_IT_IDLE)!= RESET)//空闲中断
	{
	  USART_ReceiveData(USART6);
		Uart6_Rx_Fifo.in = USART6_RX_LEN - DMA_GetCurrDataCounter(DMA2_Stream2); 
		USART_ClearITPendingBit(USART6,USART_IT_IDLE);
	} 
}	





/********************************DMA********************************************************/
//DMAx的各通道配置
//这里的传输形式是固定的,这点要根据不同的情况来修改
//从存储器->外设模式/8位数据宽度/存储器增量模式
//DMA_Streamx:DMA数据流,DMA1_Stream0~7/DMA2_Stream0~7
//chx:DMA通道选择,@ref DMA_channel DMA_Channel_0~DMA_Channel_7
//par:外设地址
//mar:存储器地址
//ndtr:数据传输量  
void MYDMA_Send_Config(DMA_Stream_TypeDef *DMA_Streamx,u32 chx,u32 par,u32 mar,u16 ndtr)
{ 
	DMA_InitTypeDef  DMA_InitStructure;
	
	if((u32)DMA_Streamx>(u32)DMA2)//得到当前stream是属于DMA2还是DMA1
	{
	  RCC_AHB1PeriphClockCmd(RCC_AHB1Periph_DMA2,ENABLE);//DMA2时钟使能 
		
	}else 
	{
	  RCC_AHB1PeriphClockCmd(RCC_AHB1Periph_DMA1,ENABLE);//DMA1时钟使能 
	}
  DMA_DeInit(DMA_Streamx);
	
	while (DMA_GetCmdStatus(DMA_Streamx) != DISABLE){}//等待DMA可配置 
	
  /* 配置 DMA Stream */
  DMA_InitStructure.DMA_Channel = chx;  //通道选择
  DMA_InitStructure.DMA_PeripheralBaseAddr = par;//DMA外设地址
  DMA_InitStructure.DMA_Memory0BaseAddr = mar;   //DMA 存储器0地址 
  DMA_InitStructure.DMA_DIR = DMA_DIR_MemoryToPeripheral;//存储器到外设模式
  DMA_InitStructure.DMA_BufferSize = ndtr;//数据传输量 
  DMA_InitStructure.DMA_PeripheralInc = DMA_PeripheralInc_Disable;//外设非增量模式
  DMA_InitStructure.DMA_MemoryInc = DMA_MemoryInc_Enable;//存储器增量模式
  DMA_InitStructure.DMA_PeripheralDataSize = DMA_PeripheralDataSize_Byte;//外设数据长度:8位
  DMA_InitStructure.DMA_MemoryDataSize = DMA_MemoryDataSize_Byte;//存储器数据长度:8位
  DMA_InitStructure.DMA_Mode = DMA_Mode_Normal;// 使用普通模式 
  DMA_InitStructure.DMA_Priority = DMA_Priority_Medium;//中等优先级
  DMA_InitStructure.DMA_FIFOMode = DMA_FIFOMode_Disable;         
  DMA_InitStructure.DMA_FIFOThreshold = DMA_FIFOThreshold_Full;
  DMA_InitStructure.DMA_MemoryBurst = DMA_MemoryBurst_Single;//存储器突发单次传输
  DMA_InitStructure.DMA_PeripheralBurst = DMA_PeripheralBurst_Single;//外设突发单次传输
  DMA_Init(DMA_Streamx, &DMA_InitStructure);//初始化DMA Stream
	DMA_Cmd(DMA_Streamx, DISABLE);   
} 

void MYDMA_Receive_Config(DMA_Stream_TypeDef *DMA_Streamx,u32 chx,u32 par,u32 mar,u16 ndtr)
{ 
	DMA_InitTypeDef  DMA_InitStructure;		
	
	if((u32)DMA_Streamx>(u32)DMA2)//得到当前stream是属于DMA2还是DMA1
	{
	  RCC_AHB1PeriphClockCmd(RCC_AHB1Periph_DMA2,ENABLE);//DMA2时钟使能 
		
	}else 
	{
	  RCC_AHB1PeriphClockCmd(RCC_AHB1Periph_DMA1,ENABLE);//DMA1时钟使能 
	}
  DMA_DeInit(DMA_Streamx);
	
	while (DMA_GetCmdStatus(DMA_Streamx) != DISABLE){}//等待DMA可配置 
	
  /* 配置 DMA Stream */
  DMA_InitStructure.DMA_Channel = chx;  //通道选择
  DMA_InitStructure.DMA_PeripheralBaseAddr = par;//DMA外设地址
  DMA_InitStructure.DMA_Memory0BaseAddr = mar;//DMA 存储器0地址
  DMA_InitStructure.DMA_DIR = DMA_DIR_PeripheralToMemory;//外设模式到存储器
  DMA_InitStructure.DMA_BufferSize = ndtr;//数据传输量 
  DMA_InitStructure.DMA_PeripheralInc = DMA_PeripheralInc_Disable;//外设非增量模式
  DMA_InitStructure.DMA_MemoryInc = DMA_MemoryInc_Enable;//存储器增量模式
  DMA_InitStructure.DMA_PeripheralDataSize = DMA_PeripheralDataSize_Byte;//外设数据长度:8位
  DMA_InitStructure.DMA_MemoryDataSize = DMA_MemoryDataSize_Byte;//存储器数据长度:8位
  DMA_InitStructure.DMA_Mode = DMA_Mode_Circular ;// 使用普通模式 
  DMA_InitStructure.DMA_Priority = DMA_Priority_Medium;//中等优先级
  DMA_InitStructure.DMA_FIFOMode = DMA_FIFOMode_Disable;         
  DMA_InitStructure.DMA_FIFOThreshold = DMA_FIFOThreshold_Full;
  DMA_InitStructure.DMA_MemoryBurst = DMA_MemoryBurst_Single;//存储器突发单次传输
  DMA_InitStructure.DMA_PeripheralBurst = DMA_PeripheralBurst_Single;//外设突发单次传输
  DMA_Init(DMA_Streamx, &DMA_InitStructure);//初始化DMA Stream
	
  DMA_Cmd(DMA_Streamx, ENABLE);
} 

//开启一次DMA传输
//DMA_Streamx:DMA数据流,DMA1_Stream0~7/DMA2_Stream0~7 
//ndtr:数据传输量  
void MYDMA_Enable(const uint8_t* buf,DMA_Stream_TypeDef *DMA_Streamx,u16 ndtr)
{
	DMA_Cmd(DMA_Streamx, DISABLE);                      //关闭DMA传输 
	
	while (DMA_GetCmdStatus(DMA_Streamx) != DISABLE){}	//确保DMA可以被设置  
		
	DMA_SetCurrDataCounter(DMA_Streamx,ndtr);          //数据传输量  
		
	DMA_Streamx->M0AR = (uint32_t)buf;                 //传输数组
 
	DMA_Cmd(DMA_Streamx, ENABLE);                      //开启DMA传输 
}	  

void printf_wrapperV(const char* format, va_list args_list)
{
	vprintf(format, args_list); 
}

void Log(uint8_t filter ,const char* format, ...)
{
	if(filter>=VERBOSE){
		va_list marker;
    va_start(marker, format);
    printf_wrapperV(format, marker);
    va_end(marker);
	}    
}
