xinshuanglong/PLC2STM-Project/Code/C/Sub/BSP/bsp_port.c

#include "bsp_include.h"

// xx:A0,B1,F10,G4等
#define GPIO_DEF(xx)                                  \
    void GPIO_##xx##_Init(void)                       \
    {                                                 \
        Gpio_Bit_Init(&GPIO_##xx);                    \
        if (GPIO_##xx.reverse == true)                \
            Gpio_Set_Bit(&GPIO_##xx);                 \
    }                                                 \
    void GPIO_##xx##_Write(int index, u8 opt)         \
    {                                                 \
        if (GPIO_##xx.reverse == false)               \
        {                                             \
            if (opt == 0)                             \
                Gpio_Reset_Bit(&GPIO_##xx);           \
            else                                      \
                Gpio_Set_Bit(&GPIO_##xx);             \
        }                                             \
        else                                          \
        {                                             \
            if (opt != 0)                             \
                Gpio_Reset_Bit(&GPIO_##xx);           \
            else                                      \
                Gpio_Set_Bit(&GPIO_##xx);             \
        }                                             \
    }                                                 \
    u8 GPIO_##xx##_Read_Input(int index)              \
    {                                                 \
        if (GPIO_##xx.reverse == true)                \
            return !Gpio_Read_Input_Bit(&GPIO_##xx);  \
        else                                          \
            return Gpio_Read_Input_Bit(&GPIO_##xx);   \
    }                                                 \
    u8 GPIO_##xx##_Read_Output(int index)             \
    {                                                 \
        if (GPIO_##xx.reverse == true)                \
            return !Gpio_Read_Output_Bit(&GPIO_##xx); \
        else                                          \
            return Gpio_Read_Output_Bit(&GPIO_##xx);  \
    }

// IO输出(高电平使能)
const Gpio_Type GPIO_E0 = {GPIOE, GPIO_Pin_0, GPIO_Mode_OUT, true};
const Gpio_Type GPIO_E1 = {GPIOE, GPIO_Pin_1, GPIO_Mode_OUT, true};
const Gpio_Type GPIO_E2 = {GPIOE, GPIO_Pin_2, GPIO_Mode_OUT, true};
const Gpio_Type GPIO_E3 = {GPIOE, GPIO_Pin_3, GPIO_Mode_OUT, true};
const Gpio_Type GPIO_E4 = {GPIOE, GPIO_Pin_4, GPIO_Mode_OUT, true};
const Gpio_Type GPIO_E5 = {GPIOE, GPIO_Pin_5, GPIO_Mode_OUT, true};
const Gpio_Type GPIO_E6 = {GPIOE, GPIO_Pin_6, GPIO_Mode_OUT, true};
const Gpio_Type GPIO_E7 = {GPIOE, GPIO_Pin_7, GPIO_Mode_OUT, true};
const Gpio_Type GPIO_E8 = {GPIOE, GPIO_Pin_8, GPIO_Mode_OUT, true};
const Gpio_Type GPIO_E9 = {GPIOE, GPIO_Pin_9, GPIO_Mode_OUT, true};
const Gpio_Type GPIO_E10 = {GPIOE, GPIO_Pin_10, GPIO_Mode_OUT, true};
const Gpio_Type GPIO_E11 = {GPIOE, GPIO_Pin_11, GPIO_Mode_OUT, true};
const Gpio_Type GPIO_E12 = {GPIOE, GPIO_Pin_12, GPIO_Mode_OUT, true};
const Gpio_Type GPIO_E13 = {GPIOE, GPIO_Pin_13, GPIO_Mode_OUT, true};

const Gpio_Type GPIO_F3 = {GPIOF, GPIO_Pin_3, GPIO_Mode_OUT, true};
const Gpio_Type GPIO_F4 = {GPIOF, GPIO_Pin_4, GPIO_Mode_OUT, true};
const Gpio_Type GPIO_F5 = {GPIOF, GPIO_Pin_5, GPIO_Mode_OUT, true};
const Gpio_Type GPIO_F6 = {GPIOF, GPIO_Pin_6, GPIO_Mode_OUT, true};
const Gpio_Type GPIO_F7 = {GPIOF, GPIO_Pin_7, GPIO_Mode_OUT, true};
const Gpio_Type GPIO_F8 = {GPIOF, GPIO_Pin_8, GPIO_Mode_OUT, true};
const Gpio_Type GPIO_F9 = {GPIOF, GPIO_Pin_9, GPIO_Mode_OUT, true};
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
        .log = "3通电动球阀2-R感应",
        .init = GPIO_D7_Init,
        .write = NULL,
        .read = GPIO_D7_Read_Input,
    },
    {
        .index = 148,
        .log = "3通电动球阀3-G感应",
        .init = GPIO_B3_Init,
        .write = NULL,
        .read = GPIO_B3_Read_Input,
    },
    {
        .index = 149,
        .log = "3通电动球阀3-R感应",
        .init = GPIO_B4_Init,
        .write = NULL,
        .read = GPIO_B4_Read_Input,
    },
    {
        .index = 150,
        .log = "3通电动球阀4-G感应",
        .init = GPIO_B5_Init,
        .write = NULL,
        .read = GPIO_B5_Read_Input,
    },
    {
        .index = 151,
        .log = "3通电动球阀4-R感应",
        .init = GPIO_B6_Init,
        .write = NULL,
        .read = GPIO_B6_Read_Input,
    },
};

void Port_Init(void)
{
    for (int i = 0; i < sizeof(gIOCtl) / sizeof(Gpio_Strategy); i++)
    {
        Gpio_Strategy gpioStrategy = gIOCtl[i];
        if (gpioStrategy.init != NULL)
            gpioStrategy.init();
    }
}

// opt 0:OFF   非0:ON
bool Port_Write(int index, u8 opt)
{
    for (int i = 0; i < sizeof(gIOCtl) / sizeof(Gpio_Strategy); i++)
    {
        Gpio_Strategy gpioStrategy = gIOCtl[i];
        if (gpioStrategy.index == index)
        {
            if (gpioStrategy.write != NULL)
            {
                gpioStrategy.write(index, opt);
                return true;
            }
            else
            {
                return false;
            }
        }
    }
    return false;
}

bool Port_Read(int index, u8 *opt)
{
    for (int i = 0; i < sizeof(gIOCtl) / sizeof(Gpio_Strategy); i++)
    {
        Gpio_Strategy gpioStrategy = gIOCtl[i];
        if (gpioStrategy.index == index)
        {
            if (gpioStrategy.read != NULL)
            {
                *opt = gpioStrategy.read(index);
                return true;
            }
            else
            {
                return false;
            }
        }
    }
    return false;
}
