xinshuanglong/PLC2STM-Project/Code/C/Main/BSP/bsp_port.c

#include "bsp_include.h"

volatile _Board gBoardSubRead;
volatile _Board gBoardSubWrite;

// xx:A0,B1,F10,G7等
#define GPIO_DEF(xx)                                  \
    void GPIO_##xx##_Init(void)                       \
    {                                                 \
        Gpio_Bit_Init(&GPIO_##xx);                    \
        if (GPIO_##xx.reverse == true)                \
            Gpio_Set_Bit(&GPIO_##xx);                 \
    }                                                 \
    void GPIO_##xx##_Write(int index, u8 opt)         \
    {                                                 \
        if (GPIO_##xx.reverse == false)               \
        {                                             \
            if (opt == 0)                             \
                Gpio_Reset_Bit(&GPIO_##xx);           \
            else                                      \
                Gpio_Set_Bit(&GPIO_##xx);             \
        }                                             \
        else                                          \
        {                                             \
            if (opt != 0)                             \
                Gpio_Reset_Bit(&GPIO_##xx);           \
            else                                      \
                Gpio_Set_Bit(&GPIO_##xx);             \
        }                                             \
    }                                                 \
    u8 GPIO_##xx##_Read_Input(int index)              \
    {                                                 \
        if (GPIO_##xx.reverse == true)                \
            return !Gpio_Read_Input_Bit(&GPIO_##xx);  \
        else                                          \
            return Gpio_Read_Input_Bit(&GPIO_##xx);   \
    }                                                 \
    u8 GPIO_##xx##_Read_Output(int index)             \
    {                                                 \
        if (GPIO_##xx.reverse == true)                \
            return !Gpio_Read_Output_Bit(&GPIO_##xx); \
        else                                          \
            return Gpio_Read_Output_Bit(&GPIO_##xx);  \
    }

// IO输出(高电平使能)
const Gpio_Type GPIO_F0 = {GPIOF, GPIO_Pin_0, GPIO_Mode_OUT, true};
const Gpio_Type GPIO_F1 = {GPIOF, GPIO_Pin_1, GPIO_Mode_OUT, true};
const Gpio_Type GPIO_F2 = {GPIOF, GPIO_Pin_2, GPIO_Mode_OUT, true};
const Gpio_Type GPIO_F3 = {GPIOF, GPIO_Pin_3, GPIO_Mode_OUT, true};
const Gpio_Type GPIO_F4 = {GPIOF, GPIO_Pin_4, GPIO_Mode_OUT, true};
const Gpio_Type GPIO_F5 = {GPIOF, GPIO_Pin_5, GPIO_Mode_OUT, true};
const Gpio_Type GPIO_F6 = {GPIOF, GPIO_Pin_6, GPIO_Mode_OUT, true};
const Gpio_Type GPIO_F7 = {GPIOF, GPIO_Pin_7, GPIO_Mode_OUT, true};
const Gpio_Type GPIO_F8 = {GPIOF, GPIO_Pin_8, GPIO_Mode_OUT, true};
const Gpio_Type GPIO_F9 = {GPIOF, GPIO_Pin_9, GPIO_Mode_OUT, true};
const Gpio_Type GPIO_F10 = {GPIOF, GPIO_Pin_10, GPIO_Mode_OUT, true};

const Gpio_Type GPIO_G7 = {GPIOG, GPIO_Pin_7, GPIO_Mode_OUT, true};

// IO读取(高电平异常)
const Gpio_Type GPIO_E0 = {GPIOE, GPIO_Pin_0, GPIO_Mode_IN, true};
const Gpio_Type GPIO_E1 = {GPIOE, GPIO_Pin_1, GPIO_Mode_IN, true};
const Gpio_Type GPIO_E2 = {GPIOE, GPIO_Pin_2, GPIO_Mode_IN, true};
const Gpio_Type GPIO_E3 = {GPIOE, GPIO_Pin_3, GPIO_Mode_IN, true};
const Gpio_Type GPIO_E4 = {GPIOE, GPIO_Pin_4, GPIO_Mode_IN, true};
const Gpio_Type GPIO_E5 = {GPIOE, GPIO_Pin_5, GPIO_Mode_IN, true};
const Gpio_Type GPIO_E6 = {GPIOE, GPIO_Pin_6, GPIO_Mode_IN, true};
const Gpio_Type GPIO_E7 = {GPIOE, GPIO_Pin_7, GPIO_Mode_IN, true};

GPIO_DEF(F0);
GPIO_DEF(F1);
GPIO_DEF(F2);
GPIO_DEF(F3);
GPIO_DEF(F4);
GPIO_DEF(F5);
GPIO_DEF(F6);
GPIO_DEF(F7);
GPIO_DEF(F8);
GPIO_DEF(F9);
GPIO_DEF(F10);

GPIO_DEF(G7);

GPIO_DEF(E0);
GPIO_DEF(E1);
GPIO_DEF(E2);
GPIO_DEF(E3);
GPIO_DEF(E4);
GPIO_DEF(E5);
GPIO_DEF(E6);
GPIO_DEF(E7);

void GPIO_Write_Sub(int index, u8 opt)
{
    uint8_t *ctl = (uint8_t *)&gBoardSubWrite.ctl;
    int a = index / 8;
    int b = index % 8;
    if (opt == 0)
        ctl[a] &= ~(1 << b);
    else
        ctl[a] |= (1 << b);
}

u8 GPIO_Read_Sub(int index)
{
    uint8_t *read = (uint8_t *)&gBoardSubRead.ctl;
    int a = index / 8;
    int b = index % 8;
    uint8_t io = read[a] & (1 << b);

    return io != 0;
}

// index:0-15   模块电源
// index:16-31  常规电源
// index:32-63  阀电源
// index:64-79  动力电源(潜水泵，采水泵等需要延时动作)
const Gpio_Strategy gIOCtl[] = {
    {
        .index = 1,
        .log = "多参数电源",
        .init = GPIO_G7_Init,
        .write = GPIO_G7_Write,
        .read = GPIO_G7_Read_Output,
    },
    {
        .index = 8,
        .log = "氨氮电源",
        .init = GPIO_F0_Init,
        .write = GPIO_F0_Write,
        .read = GPIO_F0_Read_Output,
    },
    {
        .index = 9,
        .log = "总磷电源",
        .init = GPIO_F1_Init,
        .write = GPIO_F1_Write,
        .read = GPIO_F1_Read_Output,
    },
    {
        .index = 10,
        .log = "总氮电源",
        .init = GPIO_F2_Init,
        .write = GPIO_F2_Write,
        .read = GPIO_F2_Read_Output,
    },
    {
        .index = 11,
        .log = "CODmn电源",
        .init = GPIO_F3_Init,
        .write = GPIO_F3_Write,
        .read = GPIO_F3_Read_Output,
    },
    {
        .index = 12,
        .log = "CODcr电源",
        .init = GPIO_F4_Init,
        .write = GPIO_F4_Write,
        .read = GPIO_F4_Read_Output,
    },
    {
        .index = 16,
        .log = "声光报警电源",
        .init = GPIO_F5_Init,
        .write = GPIO_F5_Write,
        .read = GPIO_F5_Read_Output,
    },
    {
        .index = 17,
        .log = "排气扇电源",
        .init = GPIO_F10_Init,
        .write = GPIO_F10_Write,
        .read = GPIO_F10_Read_Output,
    },
    {
        .index = 32,
        .log = "2通电动球阀1",
        .init = NULL,
        .write = GPIO_Write_Sub,
        .read = GPIO_Read_Sub,
    },
    {
        .index = 33,
        .log = "2通电动球阀2",
        .init = NULL,
        .write = GPIO_Write_Sub,
        .read = GPIO_Read_Sub,
    },
    {
        .index = 34,
        .log = "2通电动球阀3",
        .init = NULL,
        .write = GPIO_Write_Sub,
        .read = GPIO_Read_Sub,
    },
    {
        .index = 35,
        .log = "2通电动球阀4",
        .init = NULL,
        .write = GPIO_Write_Sub,
        .read = GPIO_Read_Sub,
    },
    {
        .index = 36,
        .log = "2通电动球阀5",
        .init = NULL,
        .write = GPIO_Write_Sub,
        .read = GPIO_Read_Sub,
    },
    {
        .index = 37,
        .log = "2通电动球阀6",
        .init = NULL,
        .write = GPIO_Write_Sub,
        .read = GPIO_Read_Sub,
    },
    {
        .index = 38,
        .log = "2通电动球阀7",
        .init = NULL,
        .write = GPIO_Write_Sub,
        .read = GPIO_Read_Sub,
    },
    {
        .index = 39,
        .log = "2通电动球阀8",
        .init = NULL,
        .write = GPIO_Write_Sub,
        .read = GPIO_Read_Sub,
    },
    {
        .index = 40,
        .log = "3通电动球阀1-G",
        .init = NULL,
        .write = GPIO_Write_Sub,
        .read = GPIO_Read_Sub,
    },
    {
        .index = 41,
        .log = "3通电动球阀1-R",
        .init = NULL,
        .write = GPIO_Write_Sub,
        .read = GPIO_Read_Sub,
    },
    {
        .index = 42,
        .log = "3通电动球阀2-G",
        .init = NULL,
        .write = GPIO_Write_Sub,
        .read = GPIO_Read_Sub,
    },
    {
        .index = 43,
        .log = "3通电动球阀2-R",
        .init = NULL,
        .write = GPIO_Write_Sub,
        .read = GPIO_Read_Sub,
    },
    {
        .index = 44,
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
        }
    }
    return false;
}

float Digita_Read(int index)
{
    if (index < 4)
    {
        return gAdcKfp[index] / 4096.0f * 20;
    }
    else if (index < 8)
    {
        return gBoardSubRead.read.digitalValue[index]; // 电流值已在副板转化
    }
    else
    {
        return 0;
    }
}
