xinshuanglong/PLC2STM-Project/Code/C/Main/BSP/bsp_SHT2x.h

#ifndef _BSP_SHT2x_H
#define _BSP_SHT2x_H
//==============================================================================
//    S E N S I R I O N   AG,  Laubisruetistr. 50, CH-8712 Staefa, Switzerland
//==============================================================================
// Project   :  SHT2x Sample Code (V1.2)
// File      :  SHT2x.h
// Author    :  MST
// Controller:  NEC V850/SG3 (uPD70F3740)
// Compiler  :  IAR compiler for V850 (3.50A)
// Brief     :  Sensor layer. Definitions of commands and registers,
//              functions for sensor access
//==============================================================================
//---------- Includes ----------------------------------------------------------

// sensor command
typedef enum
{
    TRIG_T_MEASUREMENT_HM = 0xE3,    // command trig. temp meas. hold master
    TRIG_RH_MEASUREMENT_HM = 0xE5,   // command trig. humidity meas. hold master
    TRIG_T_MEASUREMENT_POLL = 0xF3,  // command trig. temp meas. no hold master
    TRIG_RH_MEASUREMENT_POLL = 0xF5, // command trig. humidity meas. no hold master
    USER_REG_W = 0xE6,               // command writing user register
    USER_REG_R = 0xE7,               // command reading user register
    SOFT_RESET = 0xFE                // command soft reset
} etSHT2xCommand;

typedef enum
{
    SHT2x_RES_12_14BIT = 0x00, // RH=12bit, T=14bit
    SHT2x_RES_8_12BIT = 0x01,  // RH= 8bit, T=12bit
    SHT2x_RES_10_13BIT = 0x80, // RH=10bit, T=13bit
    SHT2x_RES_11_11BIT = 0x81, // RH=11bit, T=11bit
    SHT2x_RES_MASK = 0x81      // Mask for res. bits (7,0) in user reg.
} etSHT2xResolution;

typedef enum
{
    SHT2x_EOB_ON = 0x40,   // end of battery
    SHT2x_EOB_MASK = 0x40, // Mask for EOB bit(6) in user reg.
} etSHT2xEob;

typedef enum
{
    SHT2x_HEATER_ON = 0x04,   // heater on
    SHT2x_HEATER_OFF = 0x00,  // heater off
    SHT2x_HEATER_MASK = 0x04, // Mask for Heater bit(2) in user reg.
} etSHT2xHeater;

// measurement signal selection
typedef enum
{
    HUMIDITY,
    TEMP
} etSHT2xMeasureType;

typedef enum
{
    I2C_ADR_W = 128, // sensor I2C address + write bit
    I2C_ADR_R = 129  // sensor I2C address + read bit
} etI2cHeader;

// Error codes
typedef enum
{
    NO_ERROR = 0x00,
    ACK_ERROR = 0x01,
    BUSY_ERROR = 0x02,
    TIME_OUT_ERROR = 0x04,
    CHECKSUM_ERROR = 0x08,
    OPERATING_TOO_FAST = 0x10,
} etError;

typedef enum
{
    WORK_FREE = 0x00,
    WORK_MEASURE = 0x01,
} etWrokStatus;

typedef union
{
    u16 u16Val; // element specifier for accessing whole u16
    s16 s16Val; // element specifier for accessing whole i16
    struct
    {              // Byte-order is big endian
        u8 u8ValL; // element specifier for accessing high u8
        u8 u8ValH; // element specifier for accessing low u8
    } s16;         // element spec. for acc. struct with low or high u8
} nt16;

u8 SHT2X_Init(void);

//==============================================================================
u8 SHT2x_CheckCrc(u8 data[], u8 nbrOfBytes, u8 checksum);
//==============================================================================
// calculates checksum for n bytes of data and compares it with expected
// checksum
// input:  data[]       checksum is built based on this data
//         nbrOfBytes   checksum is built for n bytes of data
//         checksum     expected checksum
// return: error:       CHECKSUM_ERROR = checksum does not match
//                      0              = checksum matches

//==============================================================================
u8 SHT2x_ReadUserRegister(u8 *pRegisterValue);
//==============================================================================
// reads the SHT2x user register (8bit)
// input : -
// output: *pRegisterValue
// return: error

//==============================================================================
u8 SHT2x_WriteUserRegister(u8 *pRegisterValue);
//==============================================================================
// writes the SHT2x user register (8bit)
// input : *pRegisterValue
// output: -
// return: error

u8 SHT2X_Config_Resolutions(etSHT2xResolution resolution);

//==============================================================================
u8 SHT2x_MeasurePoll(etSHT2xMeasureType eSHT2xMeasureType, nt16 *pMeasurand);
//==============================================================================
// measures humidity or temperature. This function polls every 10ms until
// measurement is ready.
// input:  eSHT2xMeasureType
// output: *pMeasurand:  humidity / temperature as raw value
// return: error
// note:   timing for timeout may be changed

//==============================================================================
u8 SHT2x_SoftReset(void);
//==============================================================================
// performs a reset
// input:  -
// output: -
// return: error

//==============================================================================
float SHT2x_CalcRH(u16 u16sRH);
//==============================================================================
// calculates the relative humidity
// input:  sRH: humidity raw value (16bit scaled)
// return: pHumidity relative humidity [%RH]

//==============================================================================
float SHT2x_CalcTemperatureC(u16 u16sT);
//==============================================================================
// calculates temperature
// input:  sT: temperature raw value (16bit scaled)
// return: temperature [°C]

//==============================================================================
u8 SHT2x_GetSerialNumber(u8 u8SerialNumber[]);
//==============================================================================
// gets serial number of SHT2x according application note "How To
// Read-Out the Serial Number"
// note:   readout of this function is not CRC checked
//
// input:  -
// output: u8SerialNumber: Array of 8 bytes (64Bits)
//         MSB                                         LSB
//         u8SerialNumber[7]             u8SerialNumber[0]
//         SNA_1 SNA_0 SNB_3 SNB_2 SNB_1 SNB_0 SNC_1 SNC_0
// return: error

u8 SHT2x_GetTemperatureC(float *temperatureC);
u8 SHT2x_GetHumidity(float *humidity);
u8 SHT2x_GetTempCAndHumidity(float *temperatureC, float *humidity);

#endif
