xinshuanglong/PLC2STM-Project/Code/C/IAP/BSP/bsp_led.c

#include "sys.h"


#define LED_PORT       GPIOE
#define LED_PIN        GPIO_Pin_4


void Led_Init(void)
{ 
  GPIO_InitTypeDef  GPIO_InitStructure;

  RCC_AHB1PeriphClockCmd(RCC_AHB1Periph_GPIOE, ENABLE);//使能GPIO时钟

  GPIO_InitStructure.GPIO_Pin = LED_PIN ; 
  GPIO_InitStructure.GPIO_Mode = GPIO_Mode_OUT;//普通输出模式
  GPIO_InitStructure.GPIO_OType = GPIO_OType_PP;//推挽输出
  GPIO_InitStructure.GPIO_Speed = GPIO_Speed_100MHz;//100MHz
  GPIO_InitStructure.GPIO_PuPd = GPIO_PuPd_UP;//上拉
  GPIO_Init(LED_PORT, &GPIO_InitStructure);//初始化GPIO

  GPIO_ResetBits(LED_PORT,LED_PIN);
}


void Led_Ctl(uint8_t value)
{
  if(value){
    GPIO_SetBits(LED_PORT,LED_PIN);
  }else{
    GPIO_ResetBits(LED_PORT,LED_PIN); 
  }
}

void Led_Reversal(void)
{
  GPIO_ToggleBits(LED_PORT,LED_PIN);
}
