xinshuanglong/PLC2STM-Project/Code/C/Main/BSP/bsp_include.h

#ifndef __BSP_INCLUDE_H
#define __BSP_INCLUDE_H

#include "sys.h"
#include "delay.h"
#include "usart.h"
#include "iic1.h"
#include "iic2.h"
#include "iic3.h"
#include "spi1.h"
#include "spi3.h"
#include "sram.h"

#include "stack.h"
#include "float.h"
#include "alarm.h"

#include "kalmanFilter.h"

#include "iwdg.h"
#include "bsp_gpio.h"
#include "bsp_port.h"
#include "bsp_fifo.h"
#include "bsp_adc.h"
#include "bsp_tim.h"
#include "sdio_sdcard.h"

#include "bsp_ds3231.h"
#include "bsp_bm8563.h"
#include "bsp_rtc.h"
#include "bsp_SHT2x.h"
#include "bsp_cfg.h"

#include "iap.h"
#include "iwdg.h"
#include "protocol.h"
#include "app_cmd.h"
#include "app_env.h"
#include "app_adc.h"
#include "app_debug.h"
#include "app_led.h"
#include "app_sd.h"
#include "app_port.h"
#include "app_flow.h"
#include "app_com_sub.h"
#include "app_measure.h"
#include "app_bushui.h"
#include "app_baohu.h"
#include "app_bushui_andan.h"
#include "app_database.h"

#include "app_GBcmd.h"
#include "app_ev_bit.h"

#include "FreeRTOS.h"
#include "task.h"
#include "semphr.h"
#include "event_groups.h"

#include "config.h"

#include "diskio.h"
#include "ff.h"

#include <stdlib.h>
#include <stdio.h>
#include <string.h>
#include <math.h>

#endif /* __BSP_H__ */
