xinshuanglong/PLC2STM-Project/(commit log)

2022-12-29 测试:仅仅完成一体站流程执行
    [协议.xlsx]
2023-01-05 测试:添加一体站，固定站流程
    [协议.xlsx]
