xinshuanglong/PLC2STM-Project/(notices)

Notices in the files:
Code/C/Sub/BSP/stmflash.c:
Copyright(C) ¹ãÖÝÊÐÐÇÒíµç×Ó¿Æ¼¼ÓÐÏÞ¹«Ë¾ 2014-2024
All rights reserved
